jmh8231-Dev/arm-seminar/docs/PPT/ARM/ARM 세미나 8주차.pptx

## ARM Processor

Cortex-M4

세미나 8주차

Robotics 정명훈

## ARM Processor Seminar Roadmap

- 5주

- ADC & DAC

- 4주

- *UART 통신

- 2주

- 3주

- CLCD 출력

- 1주

- ARM 프로세서 개요

*Timer

- PWM

- 6주

- 7주

- USB Mass Storage

- SDIO & FATFS

- 8주

- 9주

- SPI

* 실무에 특화된 응용문제가 존재하는 회차

## Slide 3

세미나 로드맵(상세)

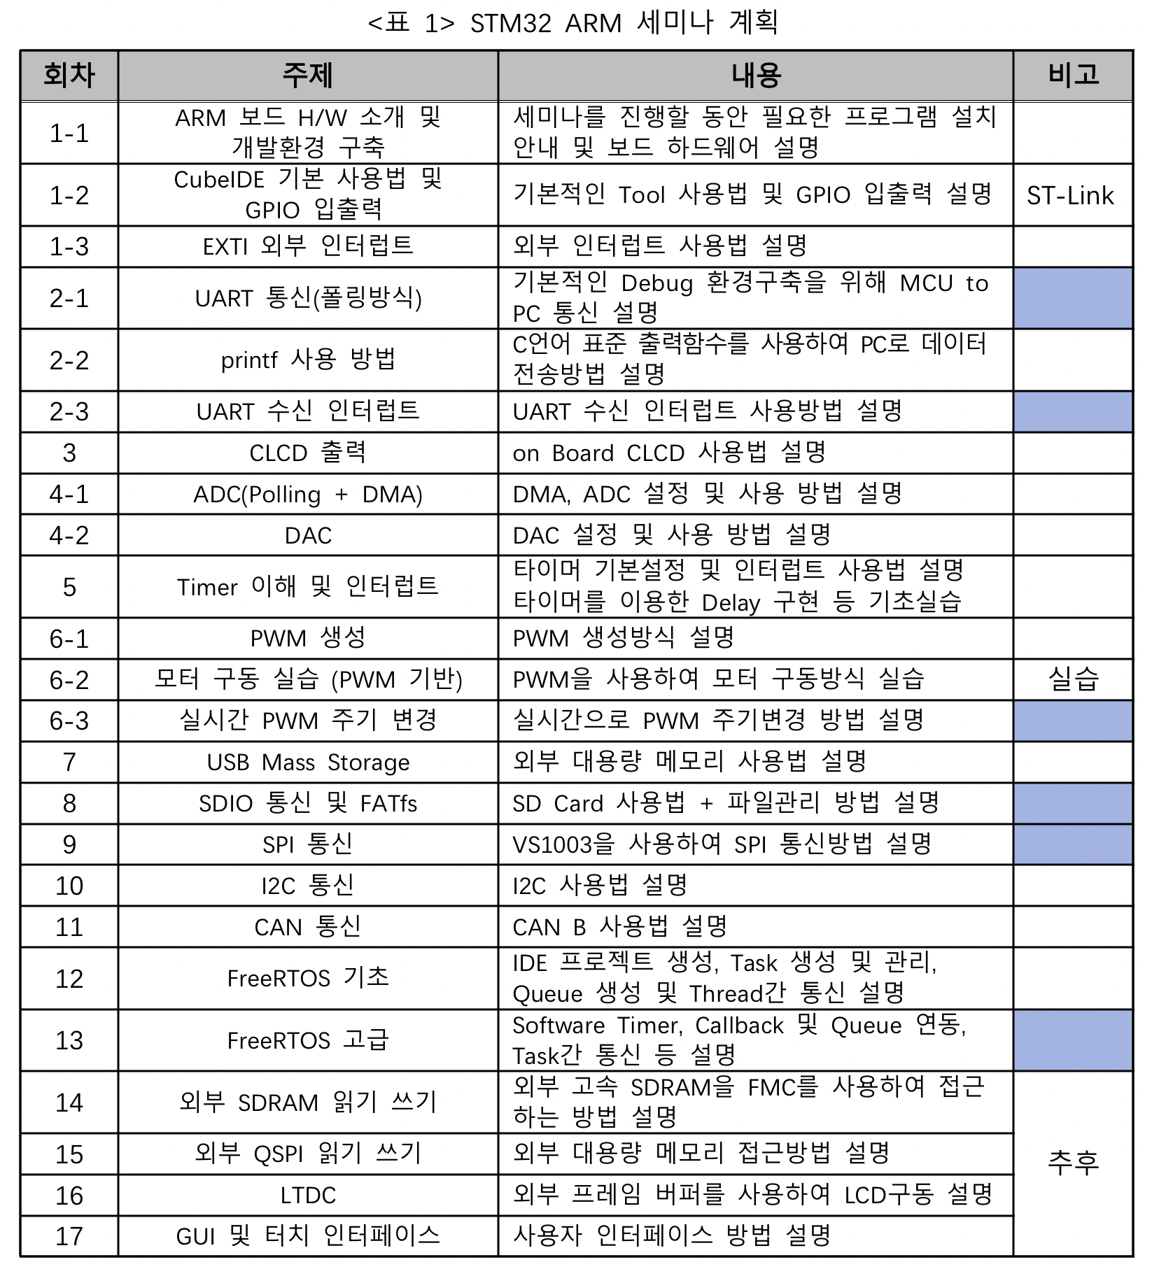
[picture p74: figure]

## 1. SDcard 1-1 MCU 내부 SDIO 하드웨어 설명

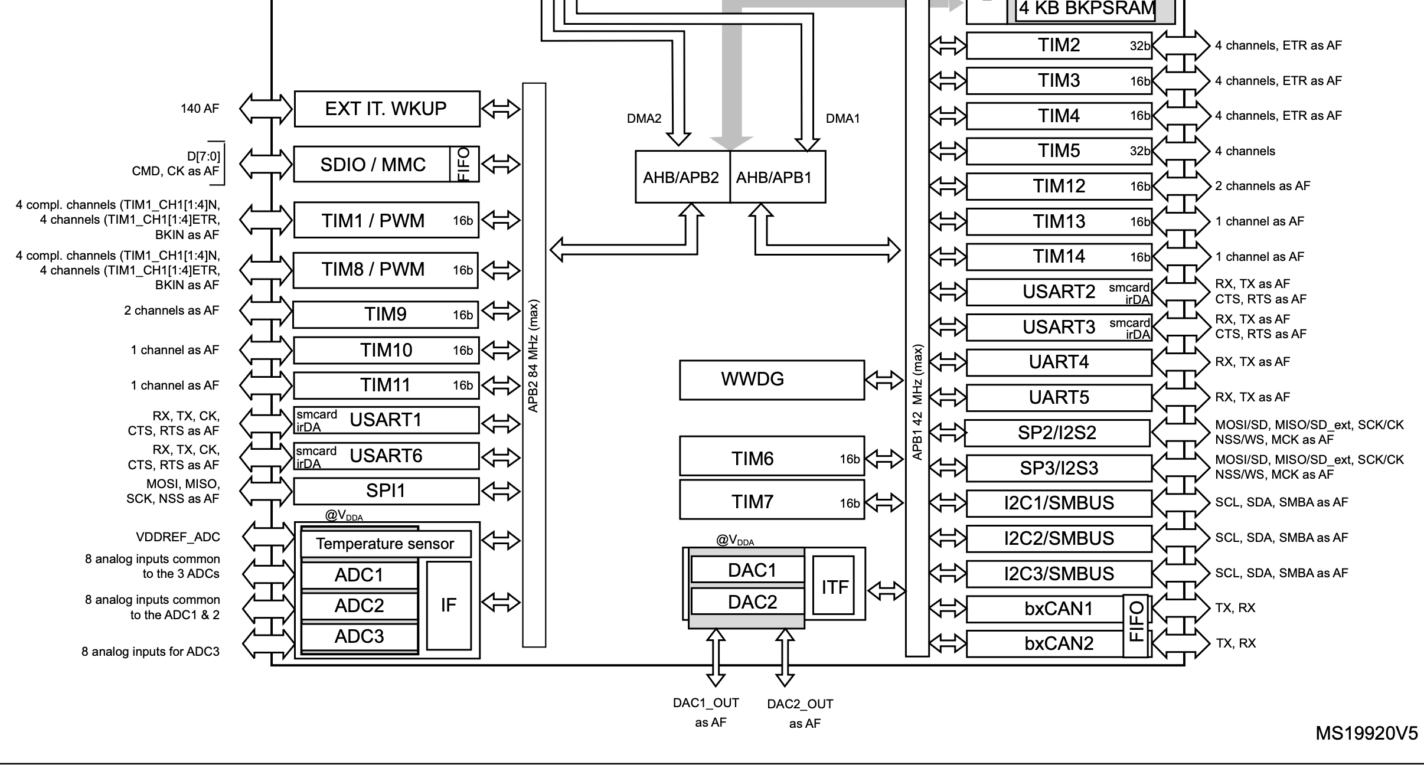
[picture p75: figure]

## 1. SDcard 1-2 PINMAP

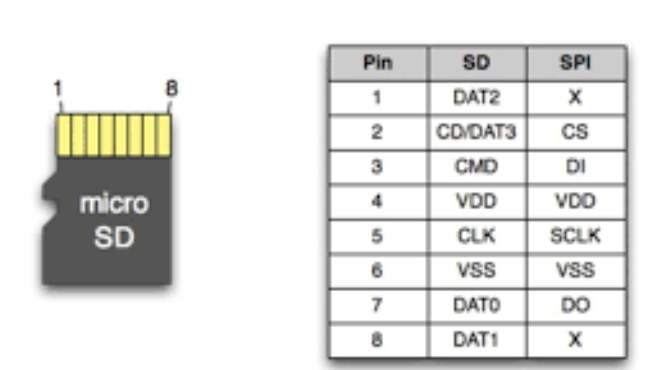
[picture p76: figure]

SDcard는 두가지 통신 방법으로 동작한다.
1. SDIO
2. SPI

## 1. SDcard 1-3 SPI vs SDIO

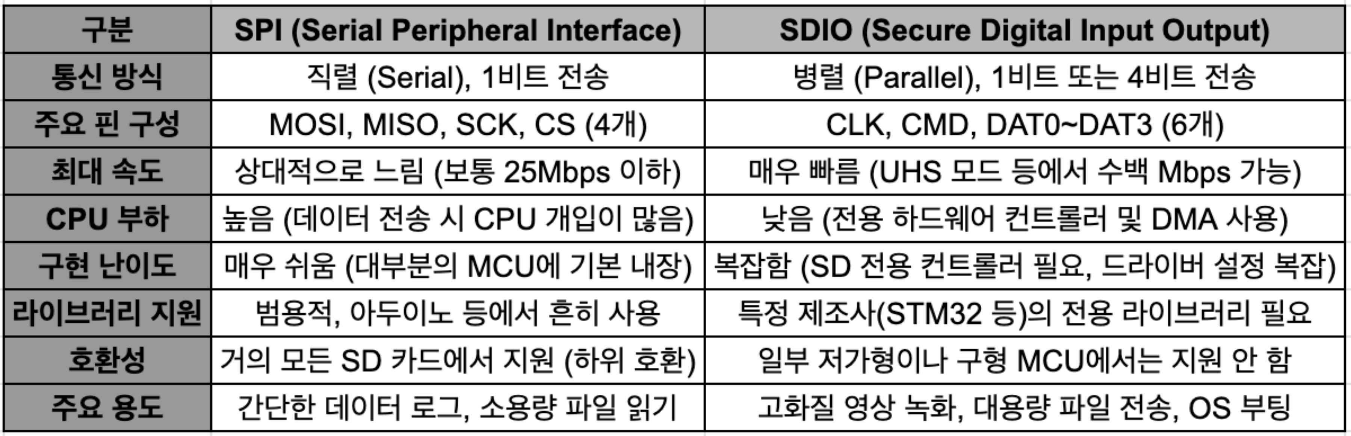
[picture p77: figure]

## 2. SDcard Hardware 2-1 PINMAP

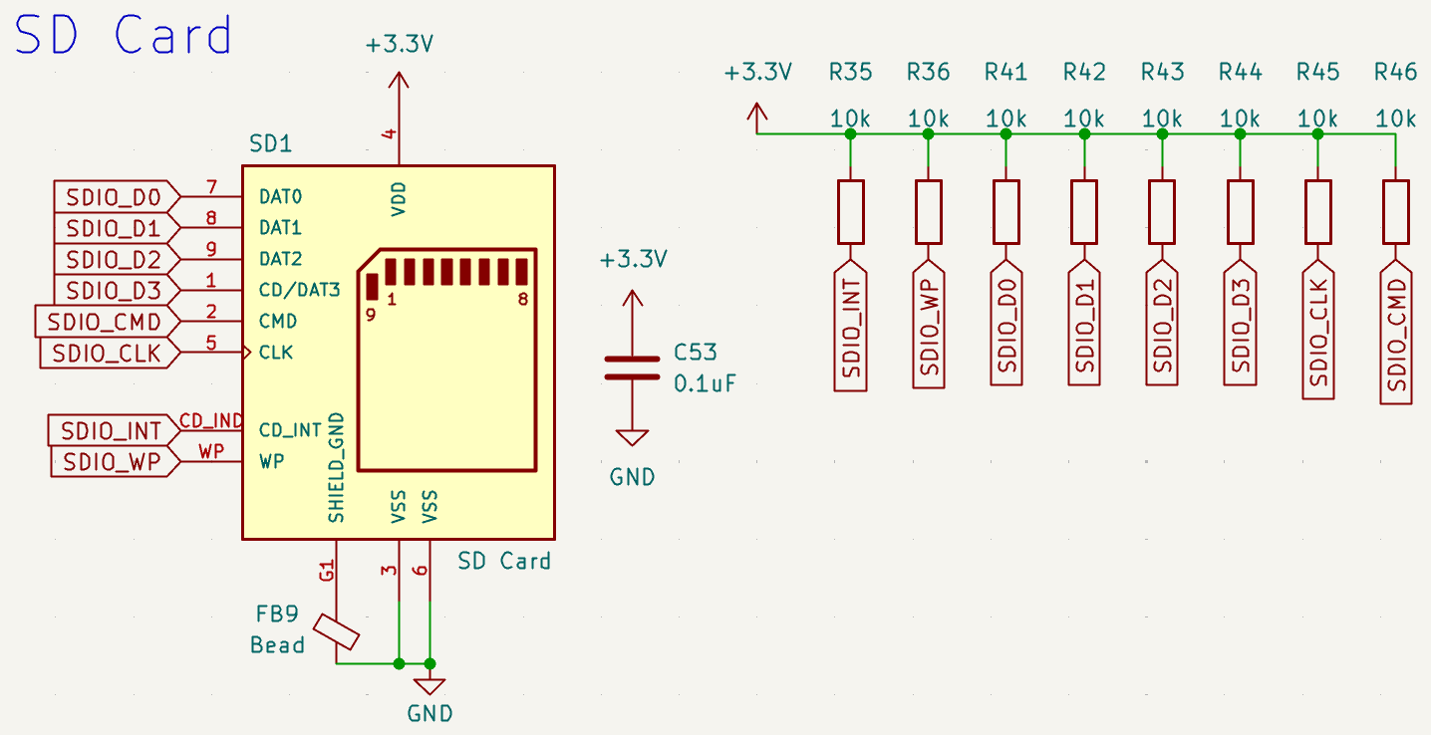
[picture p78: figure]

D0: PC8
D1: PC9
D2: PC10
D3: PC11
CMD: PD2
CLK: PC12
WP: PC6
INT: PC7

*SDIO는 Pull-UP 저항이 필수이다.

## 2. SDcard Hardware 2-2 ArtWork

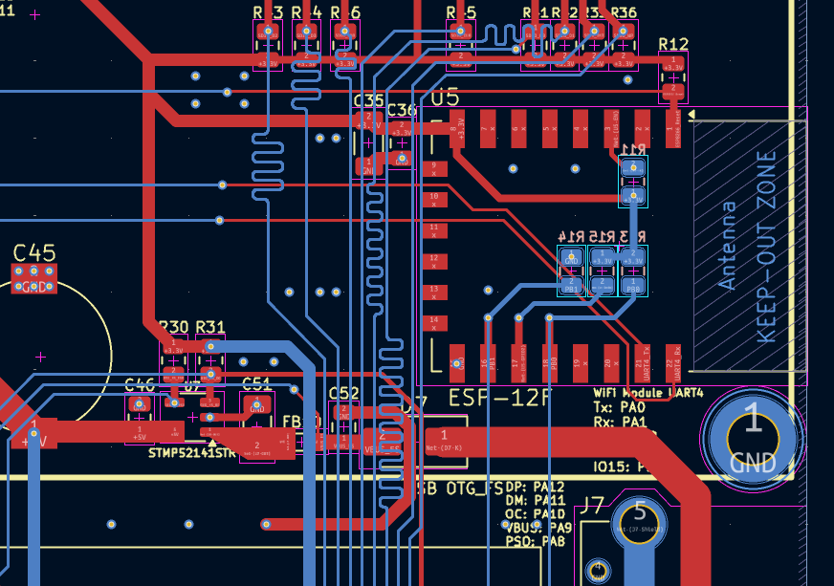
[picture p79: figure]

SDIO는 고속 통신 프로토콜 이므로
임피던스 매칭(단일 종단 50ohm)과 길이 매칭이 요구된다.

## 2. SDcard Hardware 2-3 Layout

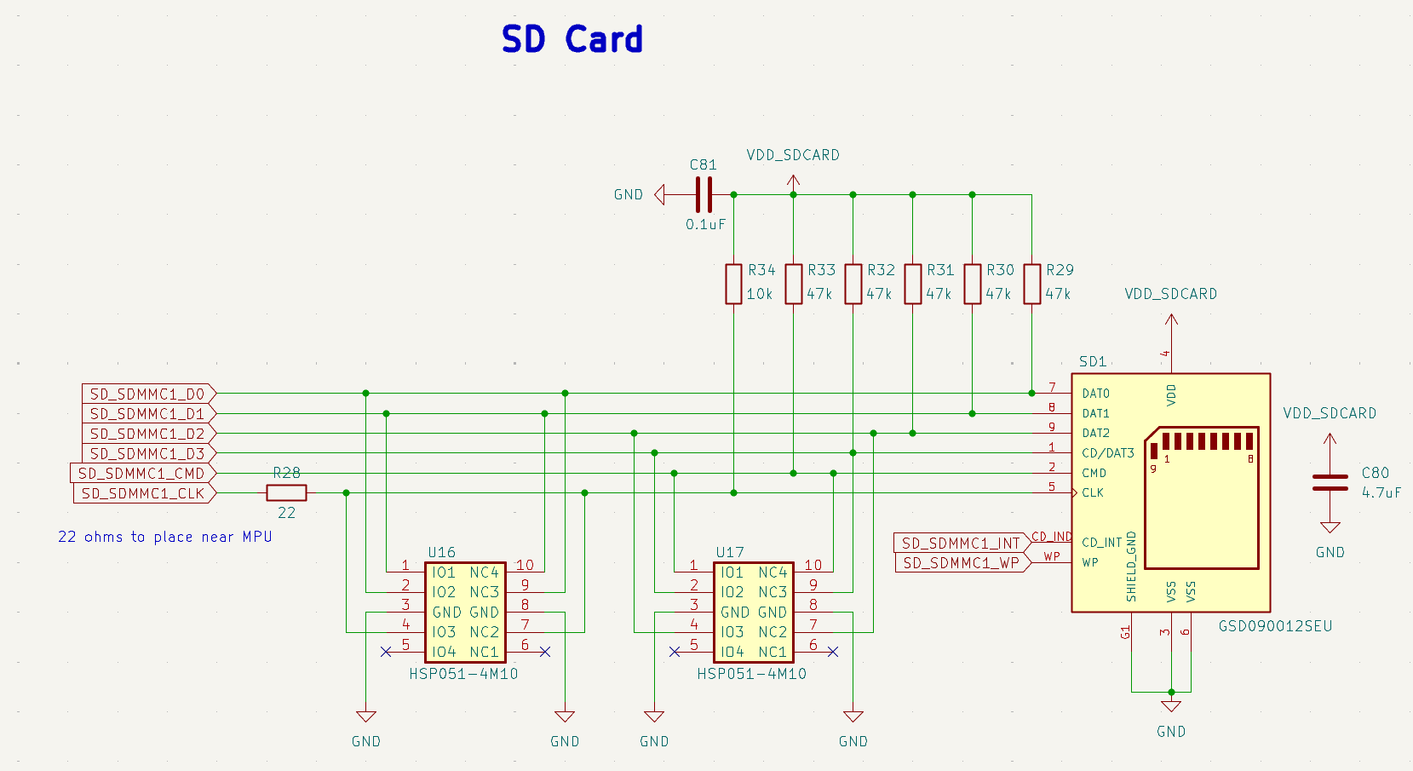
[picture p80: figure]

## 3. STM32CubeMX 설정 방법 3-1 SDIO 활성화

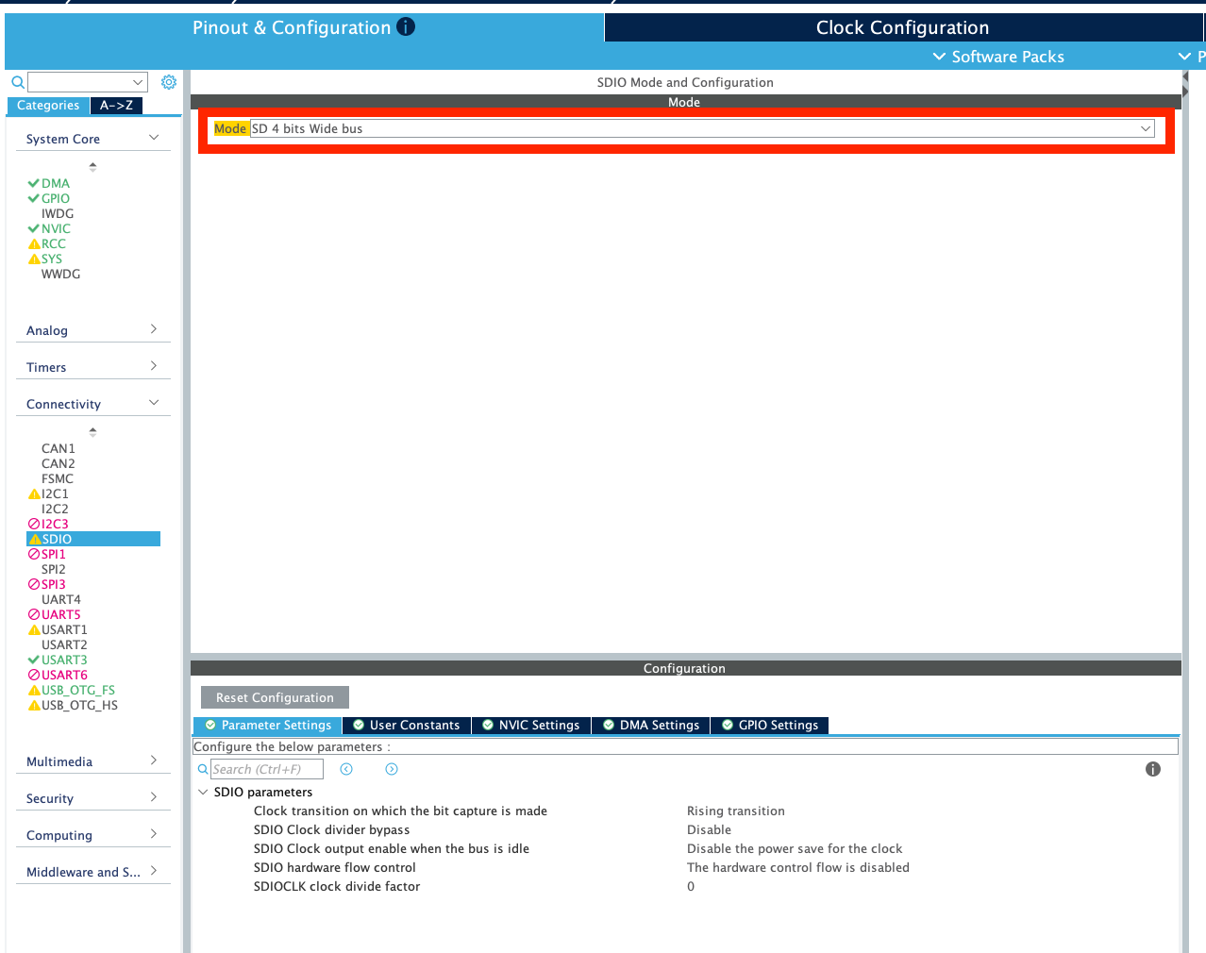
[picture p81: figure]

1. SDIO탭에서 Mode를 SD 4bit Wide bus로 활성화한다.

## 3. STM32CubeMX 설정 방법 3-2 SDIO DMA 및 인터럽트 활성화

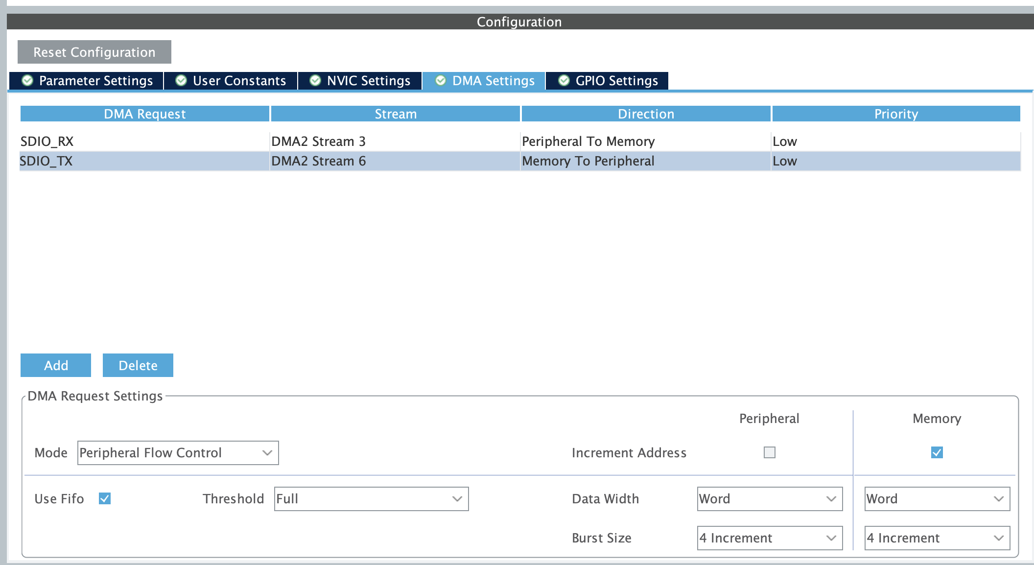
[picture p82: figure]

2. DMA Settings 탭에서 Rx, Tx DMA를 활성화 한다.
3. NVIC Settings 탭에서 글로벌 인터럽트를 활성화

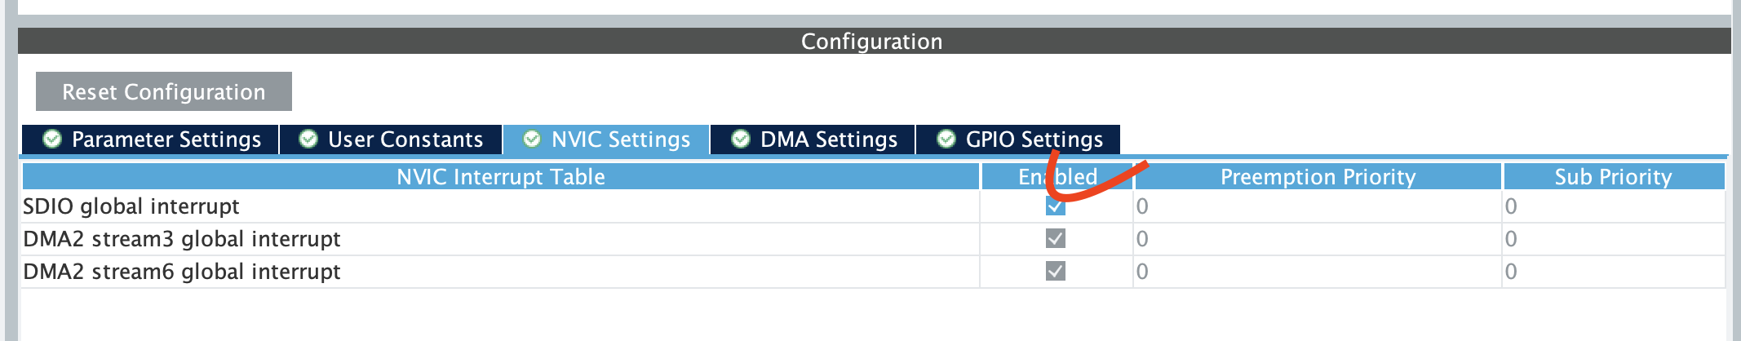
[picture p83: figure]

*만약 인터럽트를 활성화 하지 않는다면 DMA 통신에 문제가 생길 수 있다.

## 3. STM32CubeMX 설정 방법 3-3 FATFS 설정

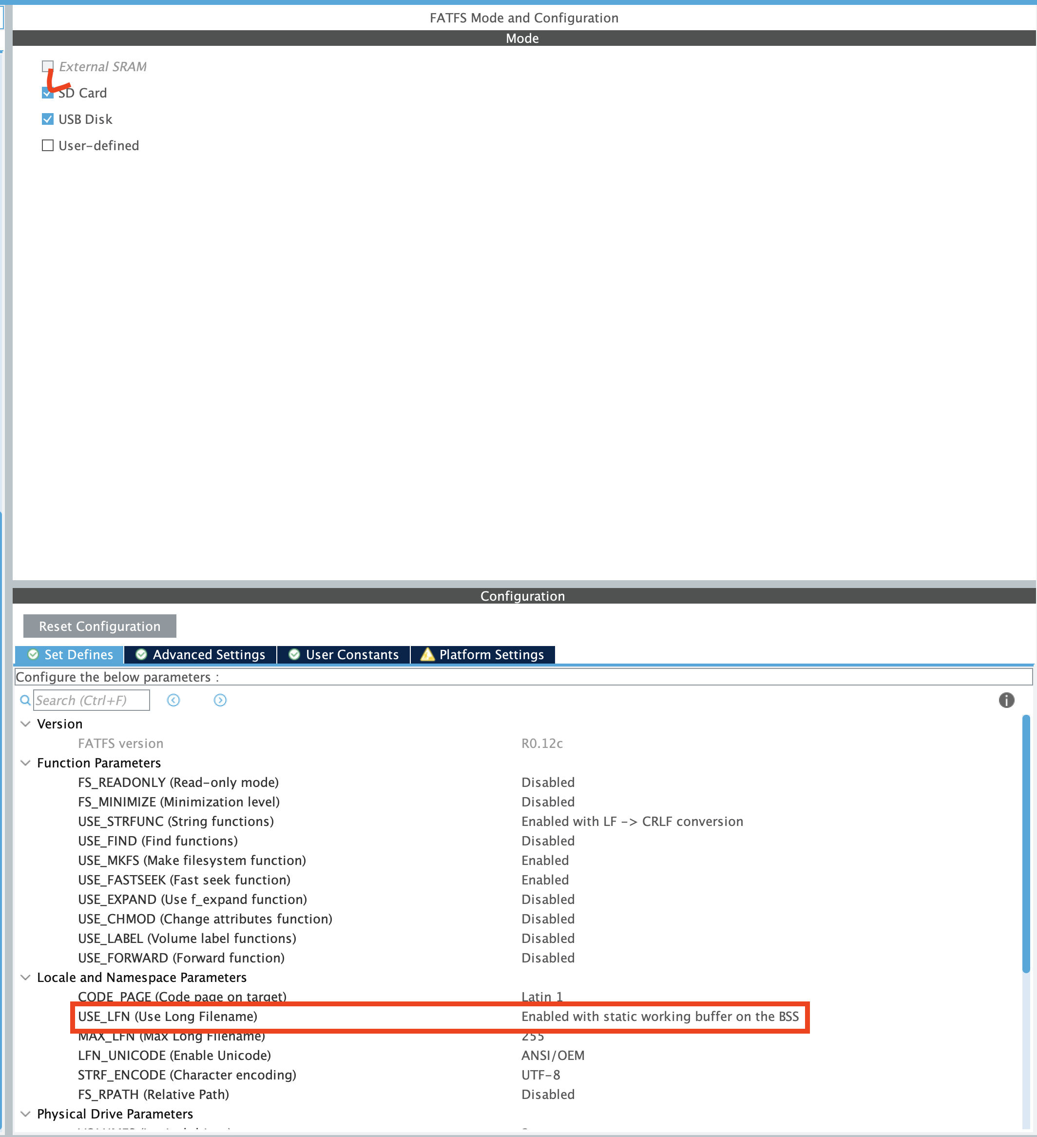
[picture p84: figure]

4. FATFS에서 SD Card를 활성화 해준다.

*이때 USE_LFN도 활성화 되어 있어야 이름이 긴 파일에 접근할 수 있다.

## 3. STM32CubeMX 설정 방법 3-4 FATFS 설정(DMA)

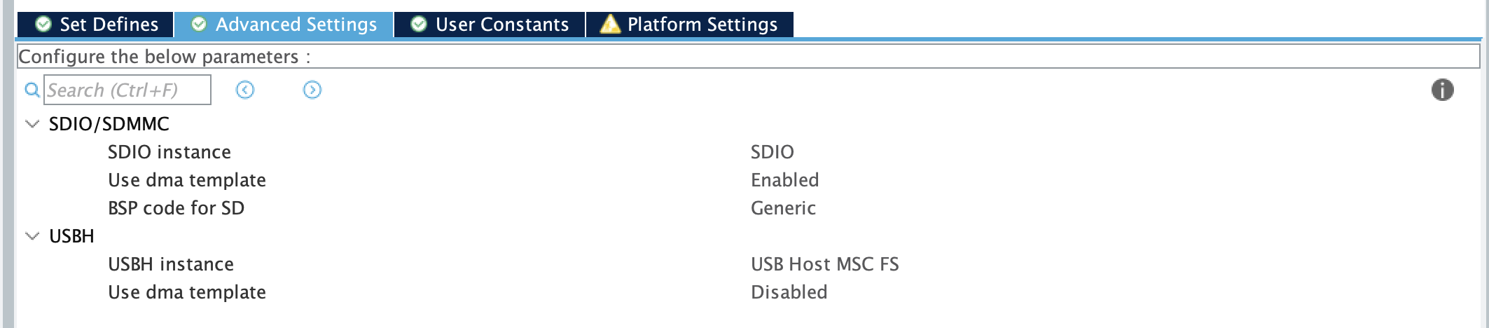
[picture p85: figure]
스크린샷, 텍스트, 소프트웨어이(가) 표시된 사진 AI 생성 콘텐츠는 정확하지 않을 수 있습니다.

5. DMA를 사용하여 통신하므로
Use dma template을 활성화 해야 한다.

## 4. STM32CubeIDE 4-1 f_mount

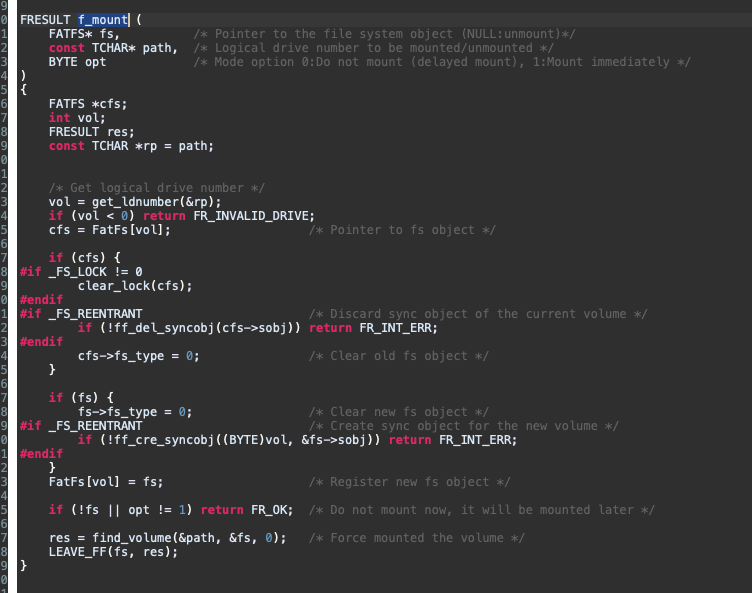
[picture p86: figure]

f_mount 함수는 매개변수가 3개이다.
이때 만약 opt = 1이라면 즉시 마운트를 시도하기 때문에
시점에 따라 opt 조절이 필요하다.

## Slide 15

회로판

실습
