jmh8231-Dev/arm-seminar/docs/Ref/PINMAP.png

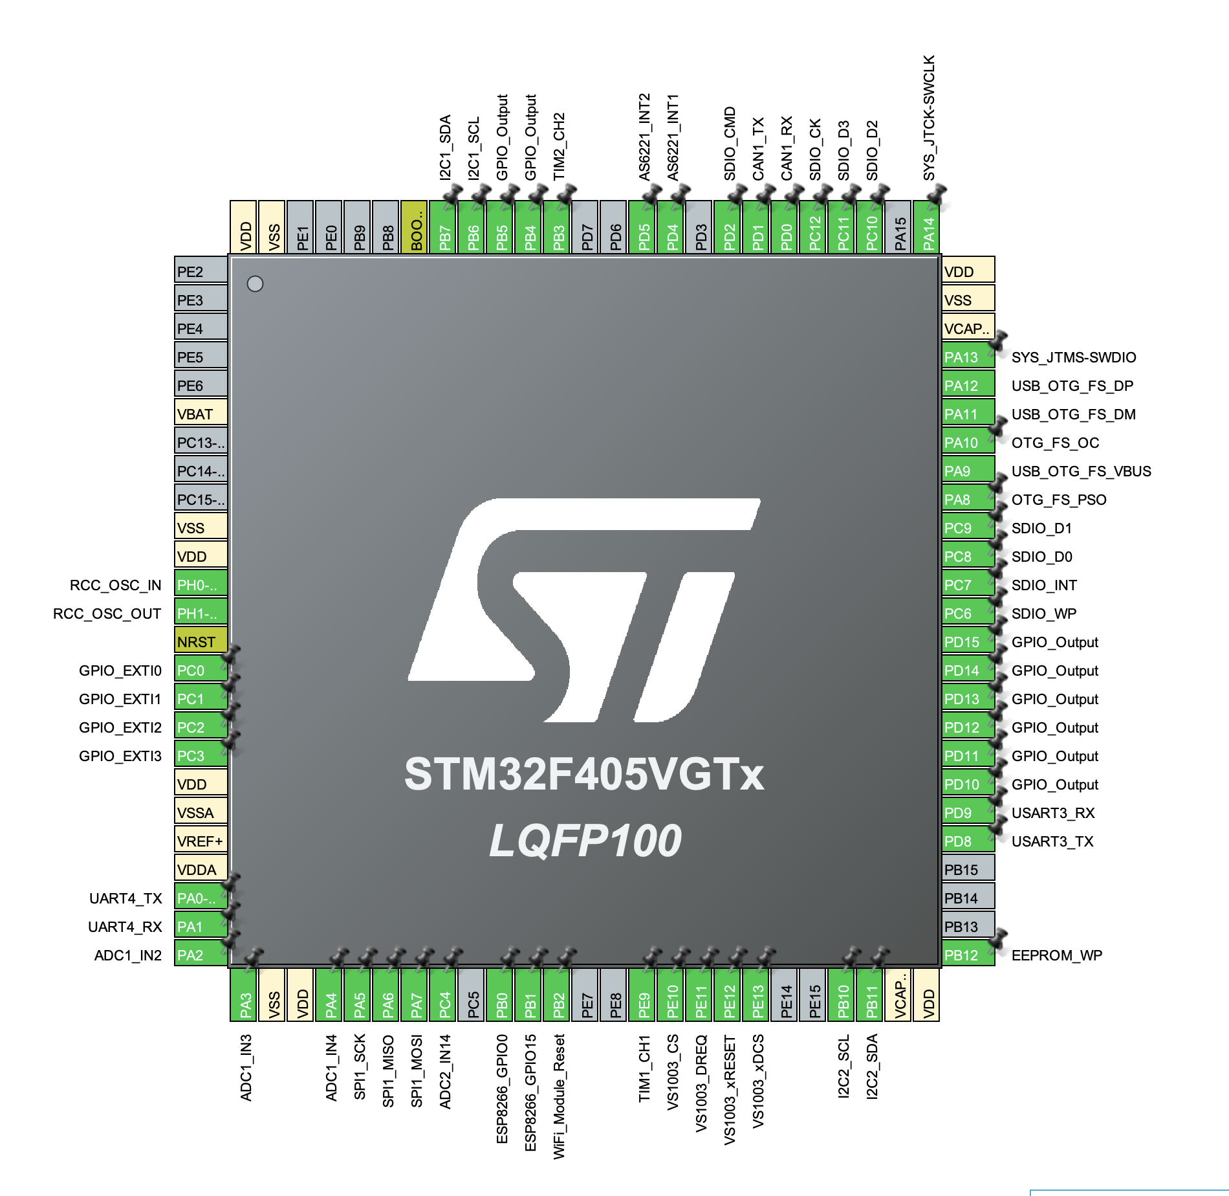
docs/Ref/PINMAP.png
