jmh8231-Dev/arm-seminar/docs/Ref/ESP32 업로드 회로(USB 커넥터 별도).pdf

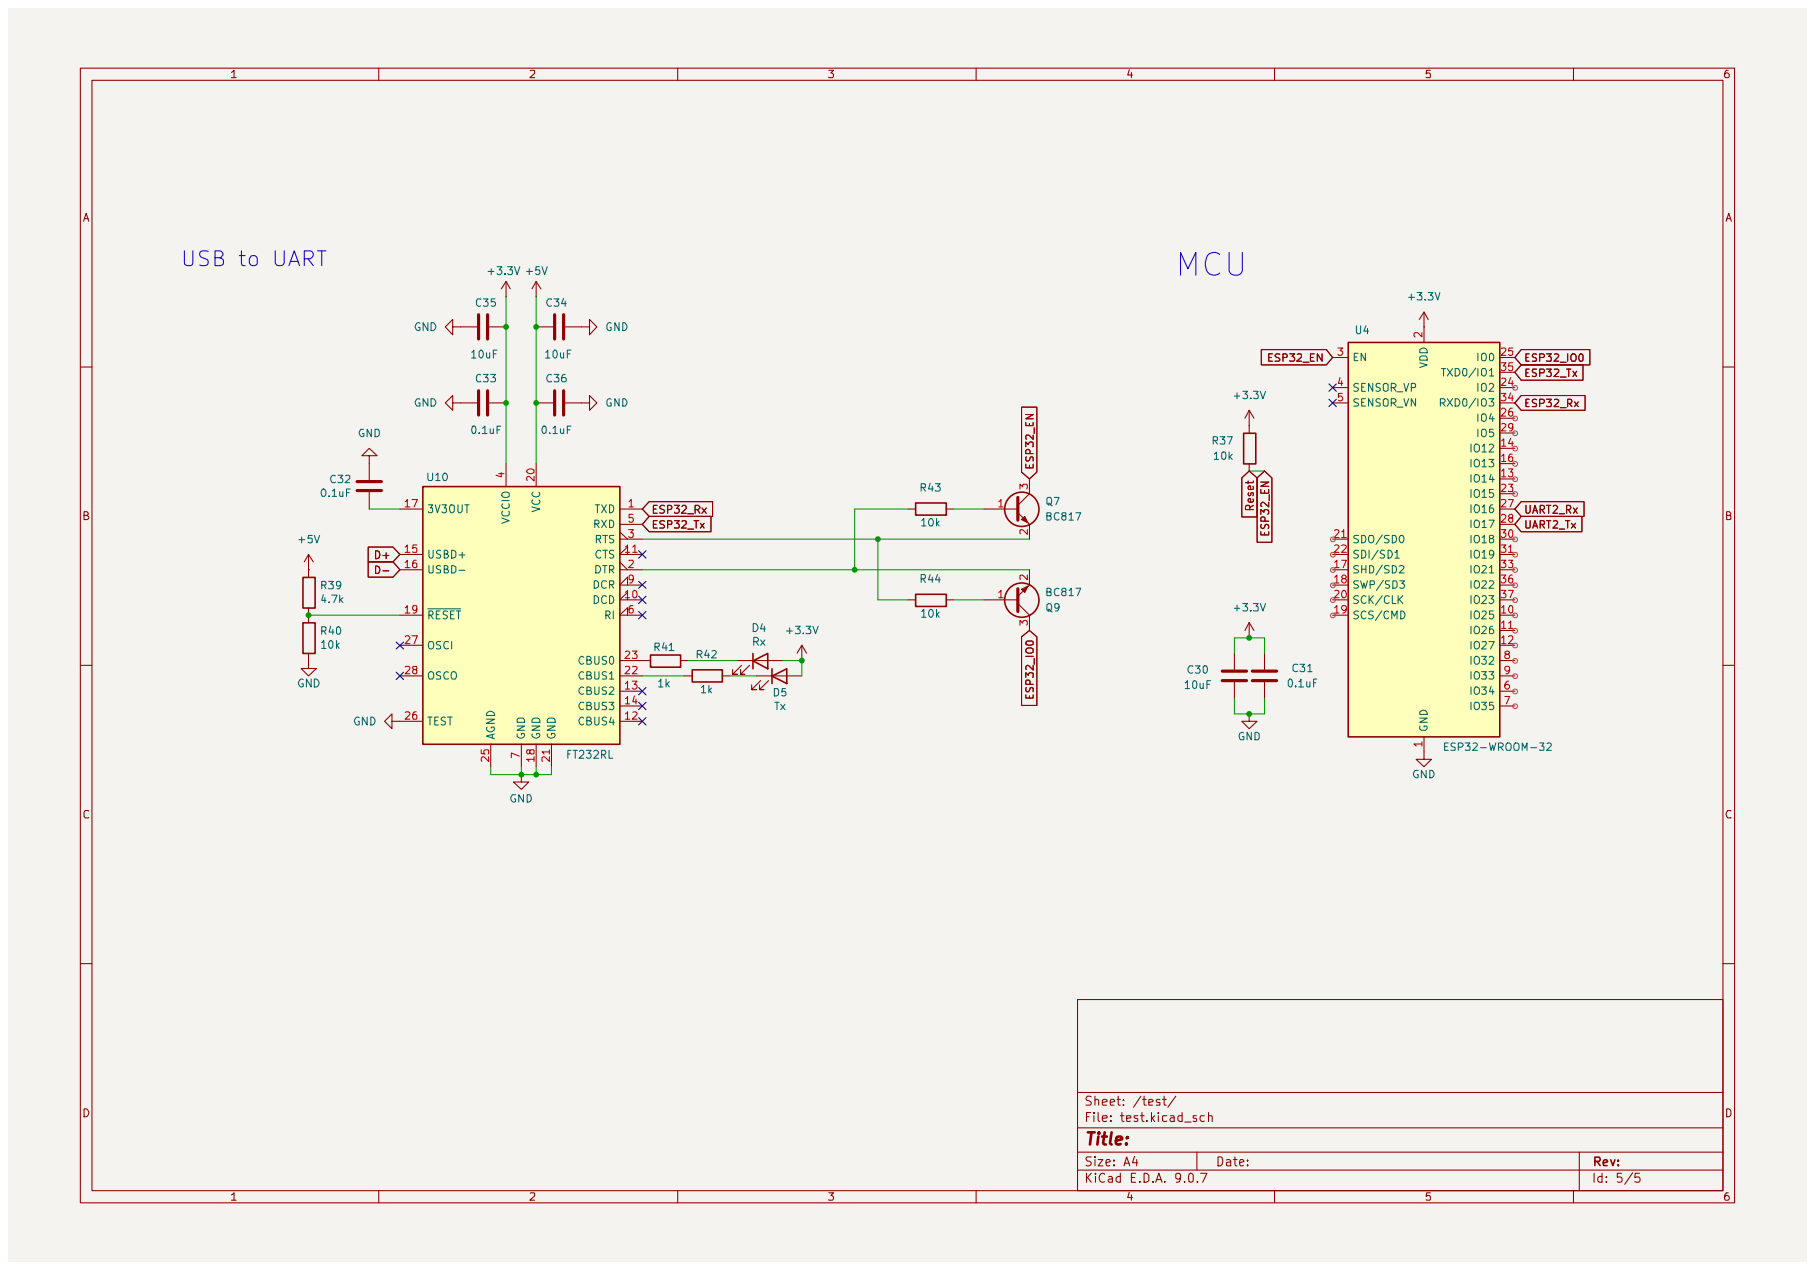
[picture p253: page 1]
