jmh8231-Dev/arm-seminar/docs/Ref/ARM Training Kit v2.0 sch.pdf

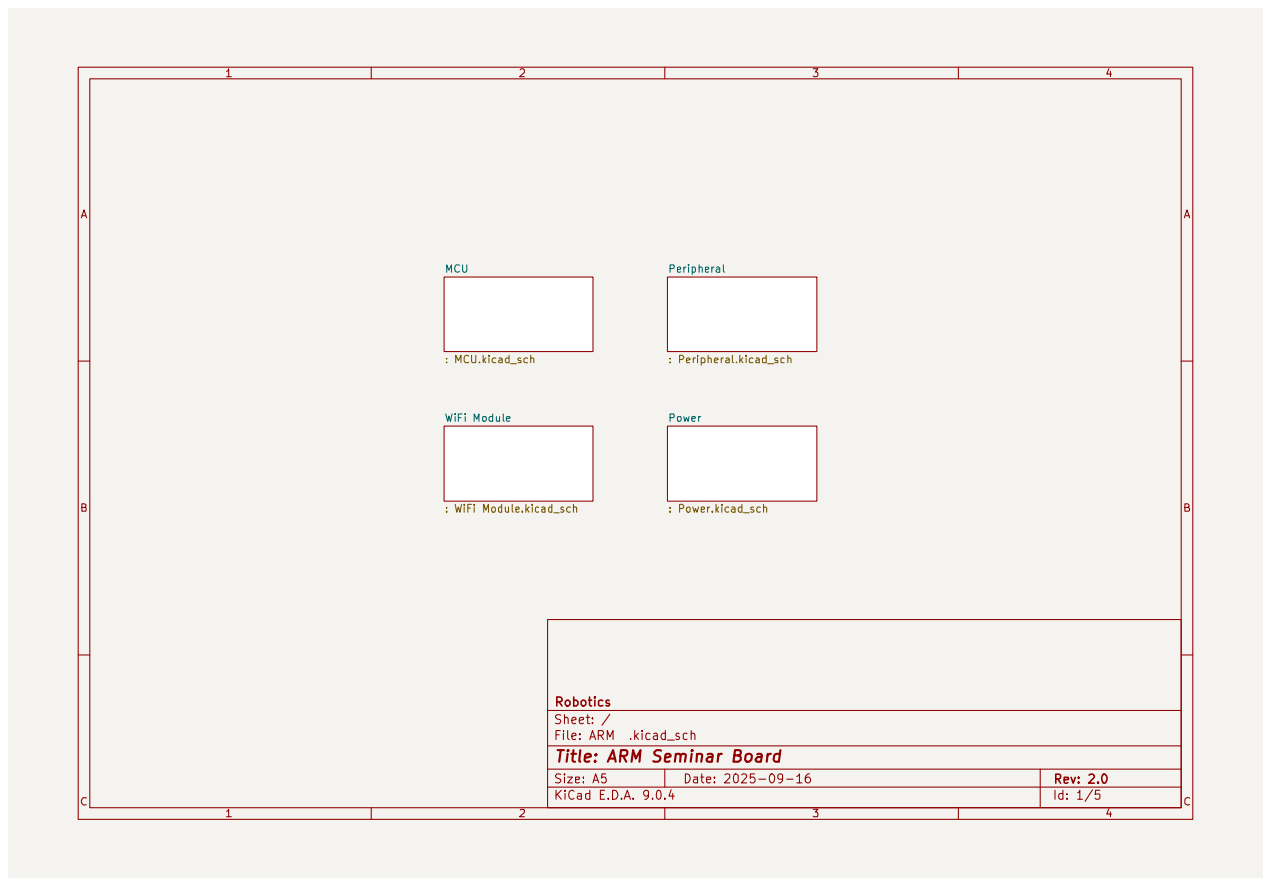
[picture p254: page 1]

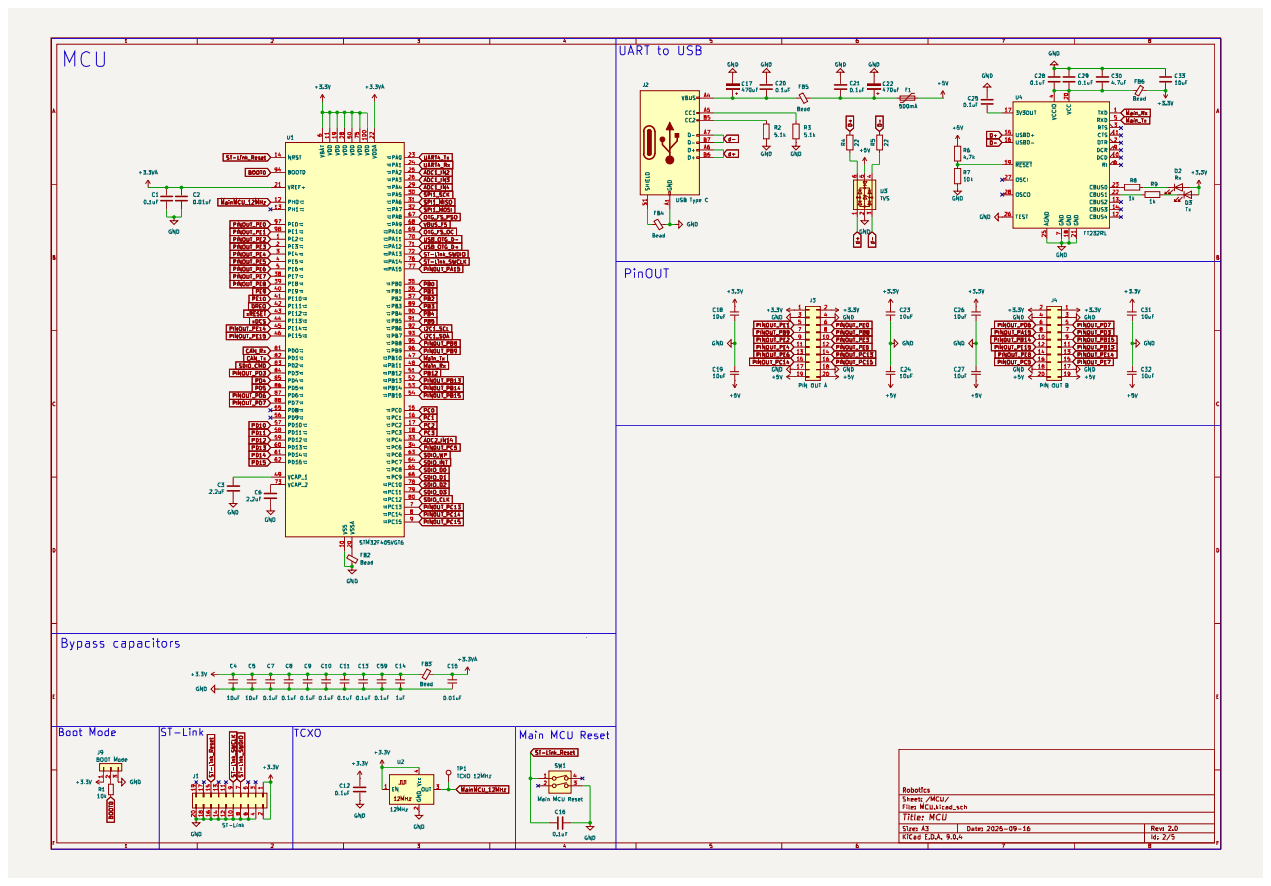
[picture p255: page 2]

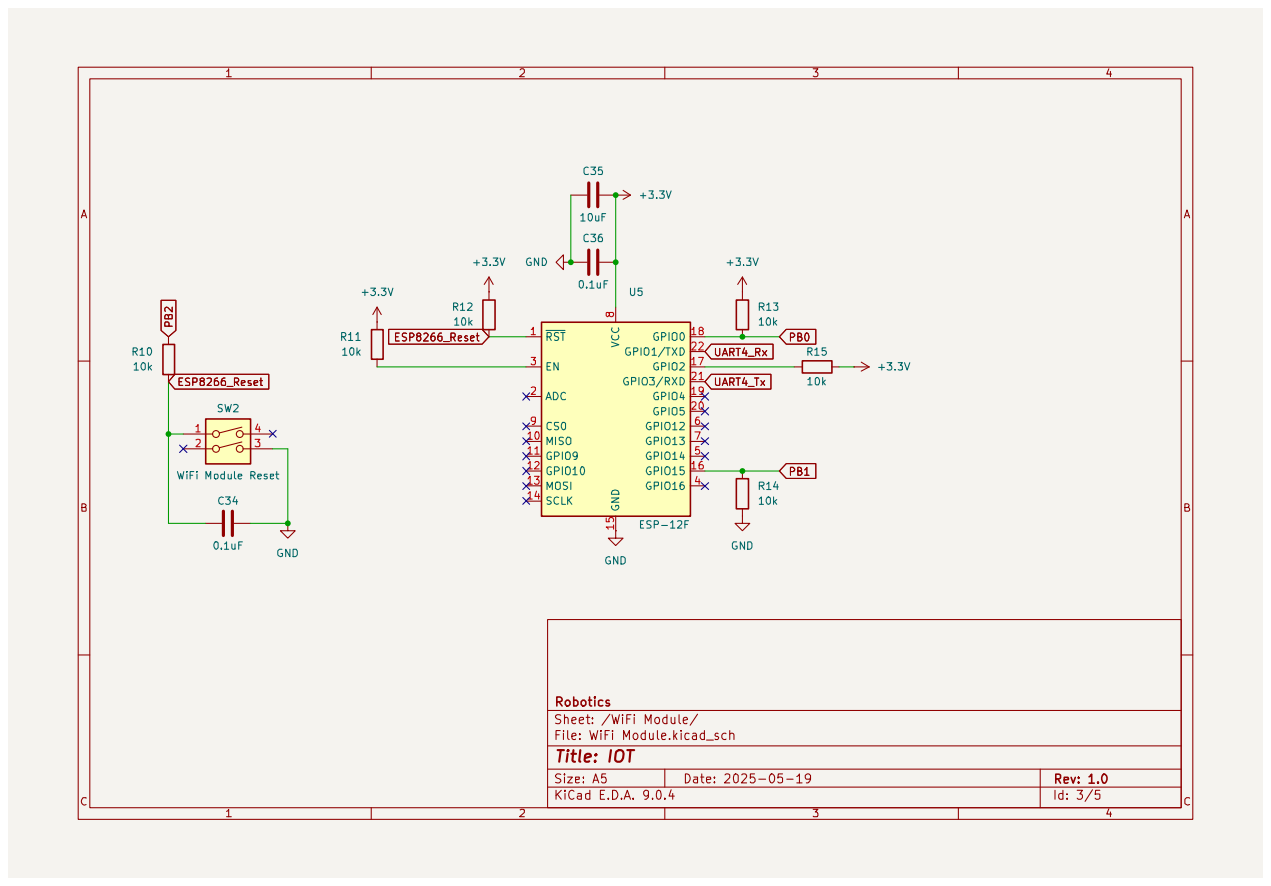
[picture p256: page 3]

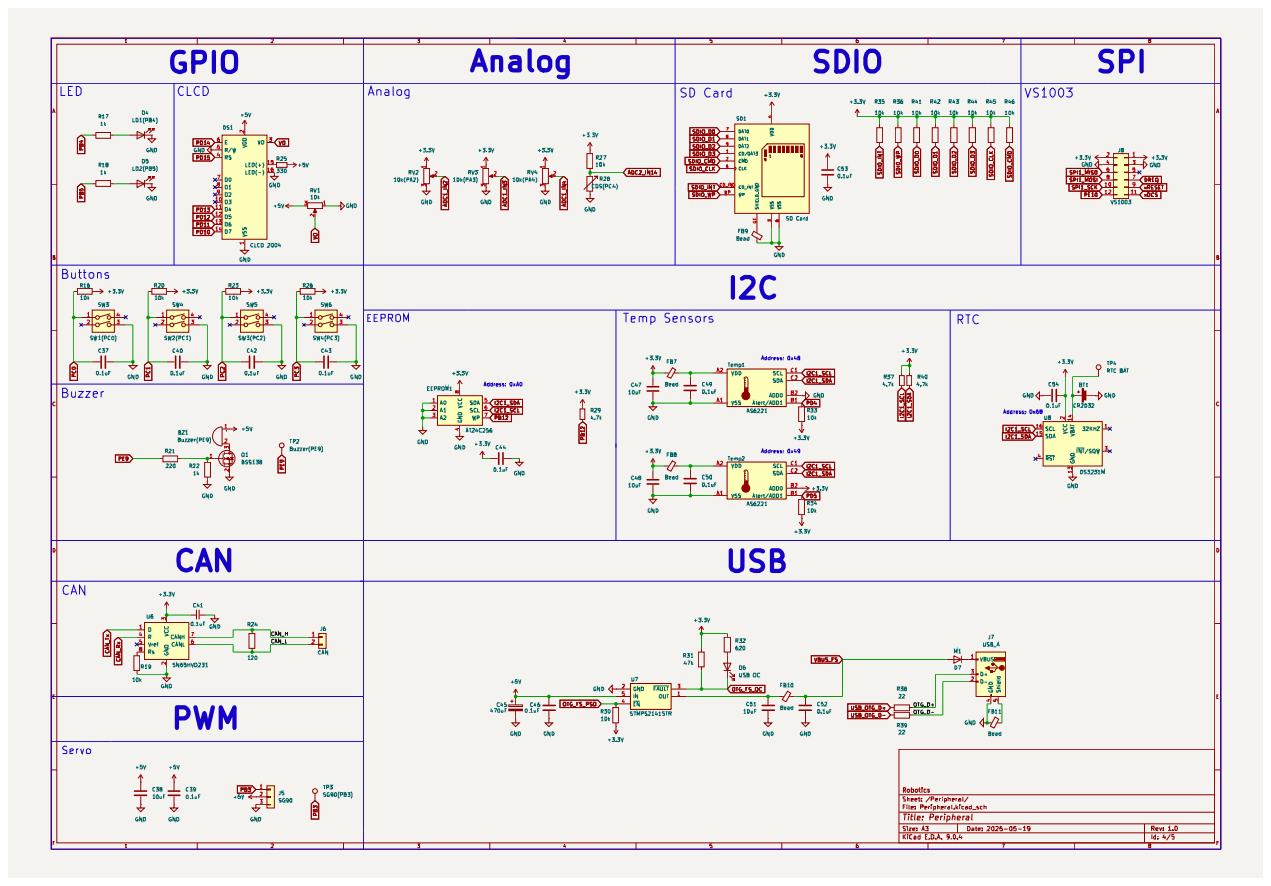
[picture p257: page 4]

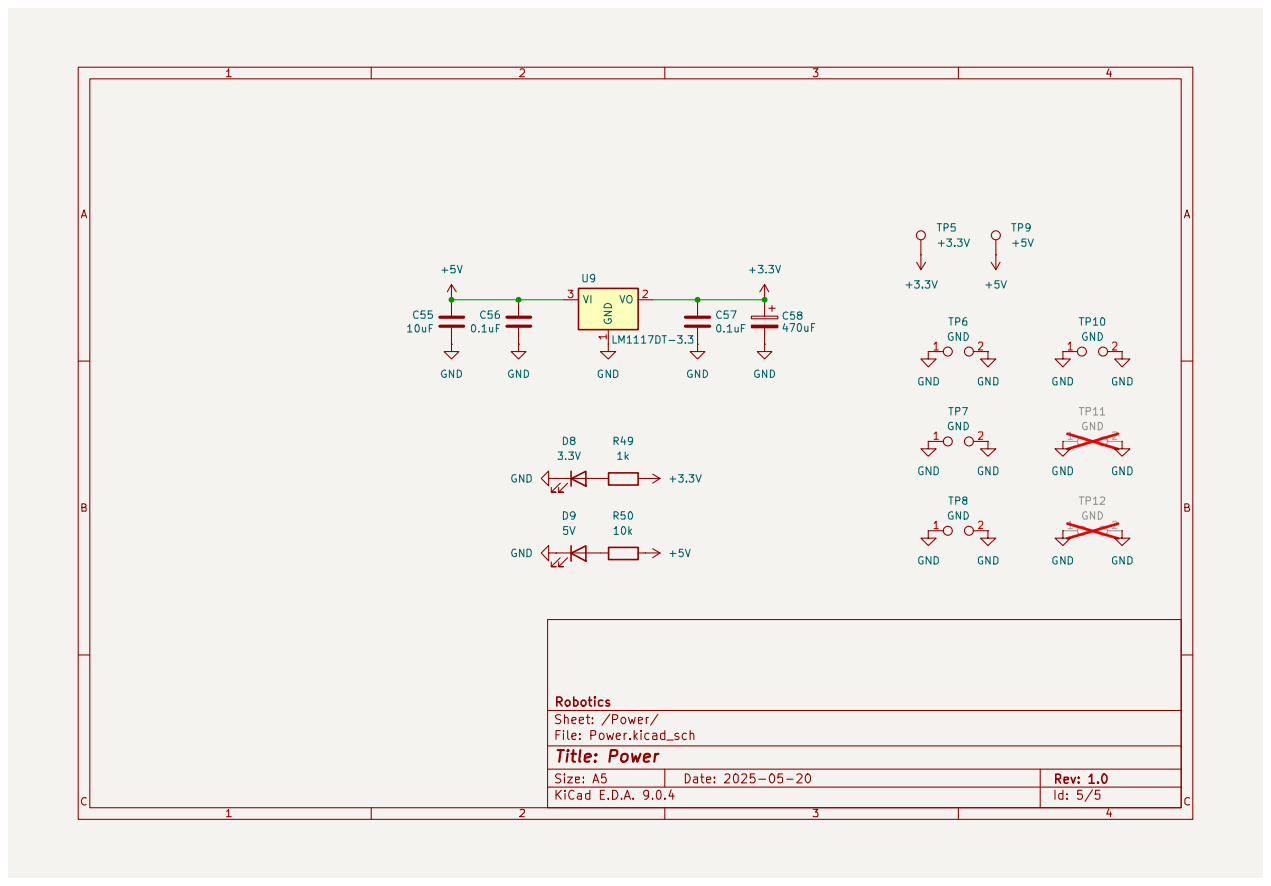
[picture p258: page 5]
