jmh8231-Dev/arm-seminar/HW/Ver 2.0/ARM 세미나 보드.kicad_pcb

## KiCad design HW/Ver 2.0/ARM 세미나 보드.kicad_pcb (2025-09-17)

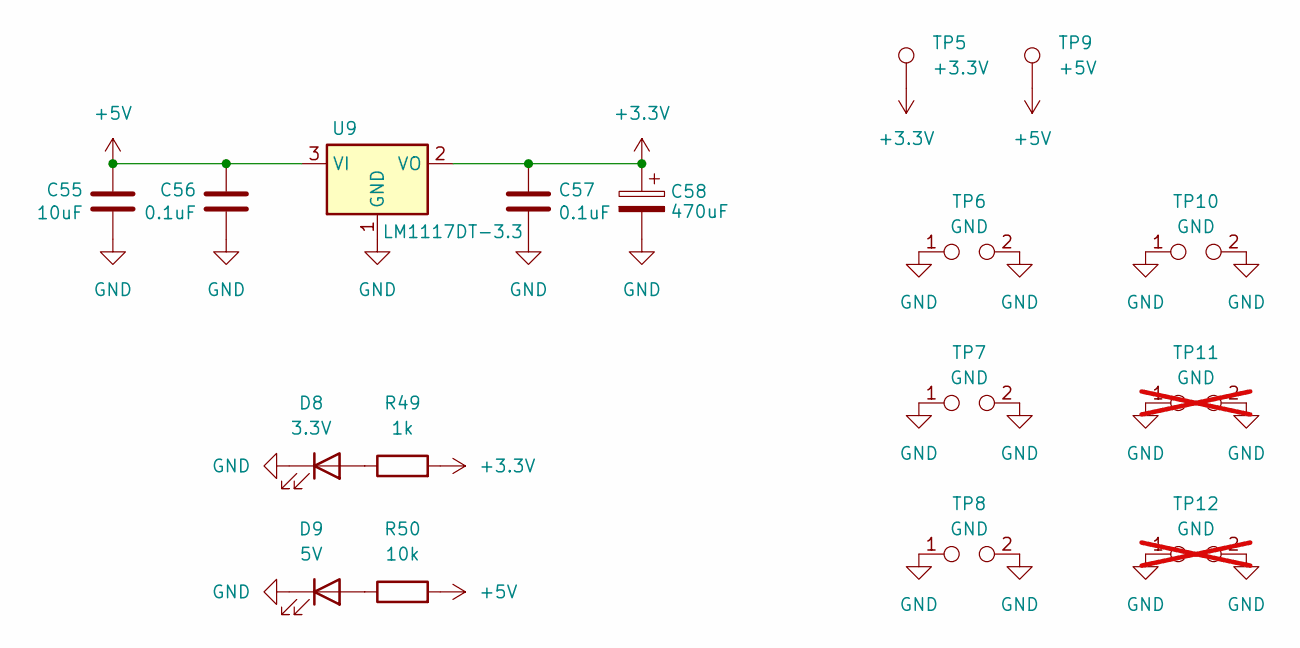
[picture p259: schematic Power.kicad_sch]

Parts:
C55: 10uF; C_1206_3216Metric
C56, C57: 0.1uF; C_0805_2012Metric
C58: 470uF; MVG25WV470M
D8: 3.3V; LED_0805_2012Metric
D9: 5V; LED_0805_2012Metric
R49: 1k; R_0805_2012Metric
R50: 10k; R_0805_2012Metric
TP5: +3.3V; TestPoint_Pad_D1.5mm
TP6, TP7, TP8, TP10: GND; TestPoint_2Pads_Pitch5.08mm_Drill1.3mm
TP9: +5V; TestPoint_Pad_D1.5mm
TP11, TP12: GND; TestPoint_2Pads_Pitch5.08mm_Drill1.3mm; not fitted
U9: LM1117DT-3.3; TO-252-3_TabPin2

Connections:
+3.3V: C57.2, C58.1, R49.2, TP5.1, U9.2 (VO); also elsewhere on the board
+5V: C55.2, C56.2, R50.2, TP9.1, U9.3 (VI); also elsewhere on the board
GND: C55.1, C56.1, C57.1, C58.2, D8.1 (K), D9.1 (K), TP6.1, TP6.2, TP7.1, TP7.2, TP8.1, TP8.2, TP10.1, TP10.2, TP11.1, TP11.2, TP12.1, TP12.2, U9.1 (GND); also elsewhere on the board
unnamed: D8.2 (A), R49.1
unnamed: D9.2 (A), R50.1

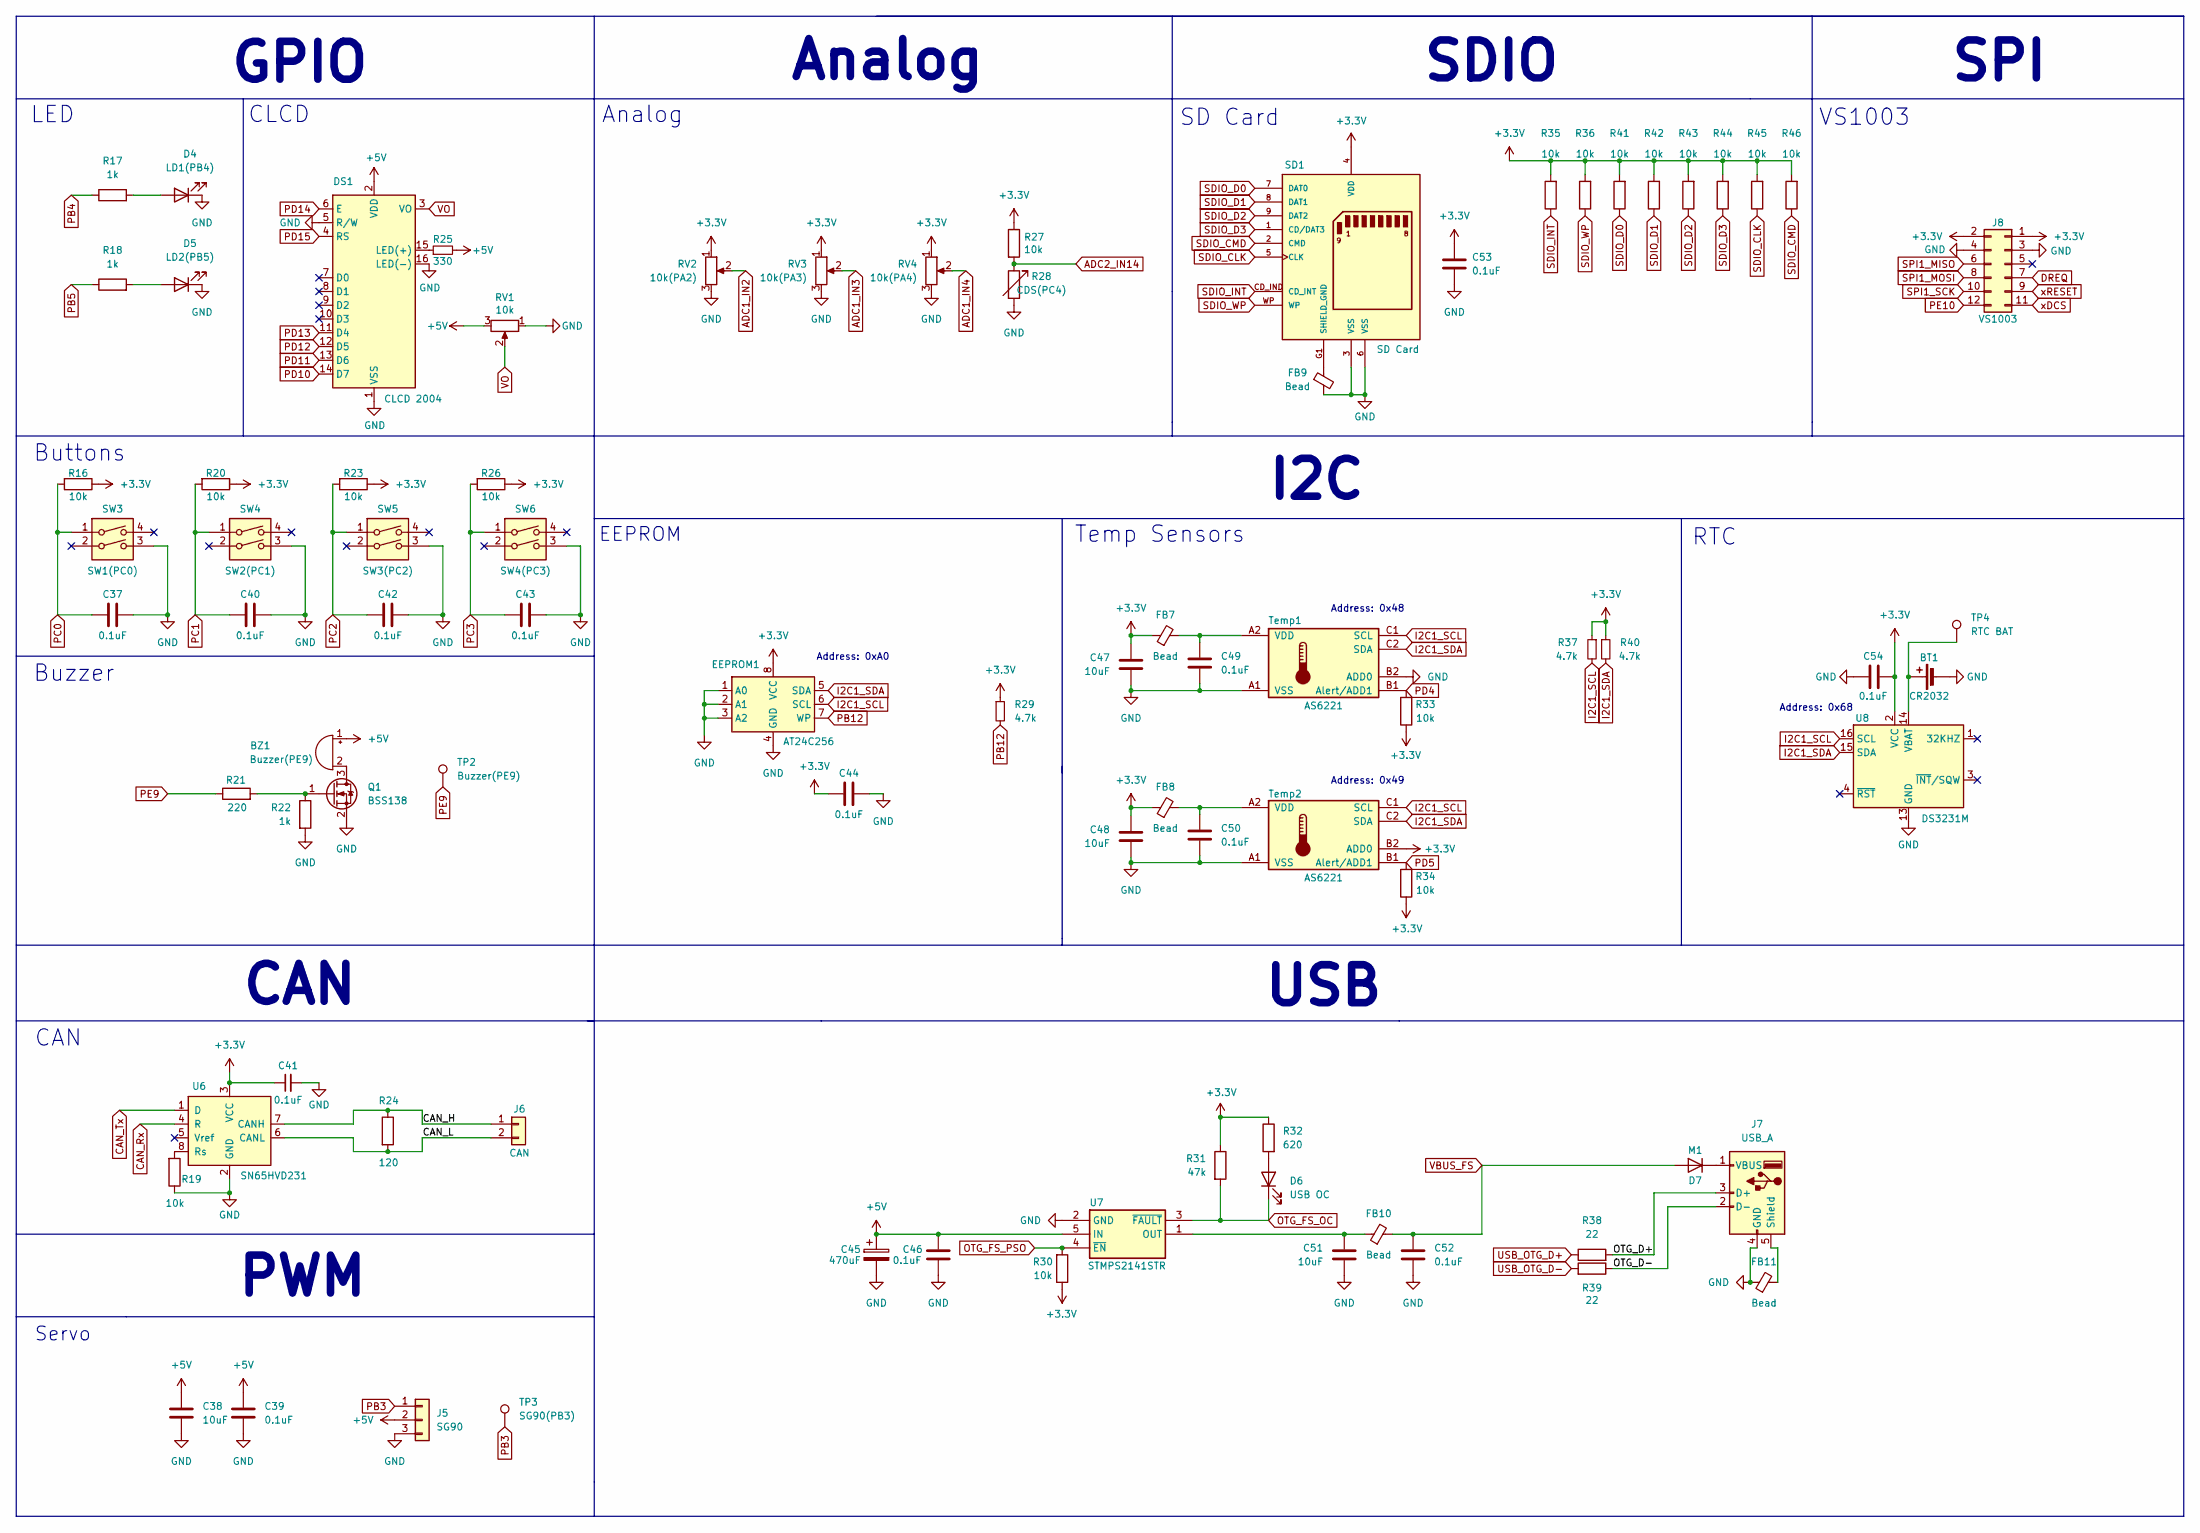
[picture p260: schematic Peripheral.kicad_sch]

Parts:
BT1: CR2032; BAT-HLD-001
BZ1: Buzzer(PE9); Buzzer_12x9.5RM7.6
C37, C39, C40, C41, C42, C43, C44, C46, C49, C50, C52, C53, C54: 0.1uF; C_0805_2012Metric
C38, C47, C48, C51: 10uF; C_1206_3216Metric
C45: 470uF; MVG25WV470M
D4: LD1(PB4); LED_0805_2012Metric
D5: LD2(PB5); LED_0805_2012Metric
D6: USB OC; LED_0805_2012Metric
D7: M1; D_SMA
DS1: CLCD 2004; LCD-20x4
EEPROM1: AT24C256; SOIC-8_3.9x4.9mm_P1.27mm
FB7, FB8, FB9, FB10, FB11: Bead; L_0805_2012Metric
J5: SG90; PinHeader_1x03_P2.54mm_Vertical
J6: CAN; PinHeader_1x02_P2.54mm_Vertical
J7: USB_A; USB_A_Connfly_DS1095
J8: VS1003; PinSocket_2x06_P2.54mm_Vertical
Q1: BSS138; SOT-23
R16, R19, R20, R23, R26, R27, R30, R33, R34, R35, R36, R41, R42, R43, R44, R45, R46: 10k; R_0805_2012Metric
R17, R18, R22: 1k; R_0805_2012Metric
R21: 220; R_0805_2012Metric
R24: 120; R_0805_2012Metric
R25: 330; R_0805_2012Metric
R28: CDS(PC4); R_LDR_5.0x4.1mm_P3mm_Vertical
R29, R37, R40: 4.7k; R_0805_2012Metric
R31: 47k; R_0805_2012Metric
R32: 620; R_0805_2012Metric
R38, R39: 22; R_0805_2012Metric
RV1: 10k; 3362P-103LF
RV2: 10k(PA2); RV09H20SQ-B10K
RV3: 10k(PA3); RV09H20SQ-B10K
RV4: 10k(PA4); RV09H20SQ-B10K
SD1: SD Card; AMPHENOL_GSD090012SEU; PARTREV E
SW3: SW1(PC0); SW_SMD_IT-1107
SW4: SW2(PC1); SW_SMD_IT-1107
SW5: SW3(PC2); SW_SMD_IT-1107
SW6: SW4(PC3); SW_SMD_IT-1107
TP2: Buzzer(PE9); TestPoint_Pad_D1.5mm
TP3: SG90(PB3); TestPoint_Pad_D1.5mm
TP4: RTC BAT; TestPoint_Pad_D1.5mm
Temp1, Temp2: AS6221; WLCSP-6_1.4x1.0mm_P0.4mm
U6: SN65HVD231; SOIC-8_3.9x4.9mm_P1.27mm
U7: STMPS2141STR; SOT-23-5
U8: DS3231M; SOIC-16W_7.5x10.3mm_P1.27mm

Connections:
+3.3V: C41.1, C44.1, C47.2, C48.2, C53.1, C54.2, EEPROM1.8 (VCC), FB7.1, FB8.1, J8.1, J8.2, R16.1, R20.1, R23.1, R26.1, R27.1, R29.1, R30.1, R31.1, R32.1, R33.1, R34.1, R35.2, R36.2, R37.1, R40.1, R41.2, R42.2, R43.2, R44.2, R45.2, R46.2, RV2.1, RV3.1, RV4.1, SD1.4 (VDD), Temp2.B2 (ADD0), U6.3 (VCC), U8.2 (VCC); also elsewhere on the board
+5V: BZ1.1 (+), C38.1, C39.1, C45.1, C46.1, DS1.2 (VDD), J5.2, R25.2, RV1.3, U7.5 (IN); also elsewhere on the board
/Peripheral/CAN_H: J6.1, R24.1, U6.7 (CANH)
/Peripheral/CAN_L: J6.2, R24.2, U6.6 (CANL)
/Peripheral/OTG_D+: J7.3 (D+), R38.2
/Peripheral/OTG_D-: J7.2 (D-), R39.1
ADC1_IN2: RV2.2; also elsewhere on the board
ADC1_IN3: RV3.2; also elsewhere on the board
ADC1_IN4: RV4.2; also elsewhere on the board
ADC2_IN14: R27.2, R28.1; also elsewhere on the board
CAN_Rx: U6.4 (R); also elsewhere on the board
CAN_Tx: U6.1 (D); also elsewhere on the board
DREQ: J8.7; also elsewhere on the board
GND: BT1.2 (-), C37.2, C38.2, C39.2, C40.2, C41.2, C42.2, C43.2, C44.2, C45.2, C46.2, C47.1, C48.1, C49.2, C50.2, C51.1, C52.2, C53.2, C54.1, D4.1 (K), D5.1 (K), DS1.1 (VSS), DS1.5 (R/W), DS1.16 (LED(-)), EEPROM1.1 (A0), EEPROM1.2 (A1), EEPROM1.3 (A2), EEPROM1.4 (GND), FB9.2, FB11.1, J5.3, J7.4 (GND), J8.3, J8.4, Q1.2 (S), R19.1, R22.2, R28.2, RV1.1, RV2.3, RV3.3, RV4.3, SD1.3 (VSS), SD1.6 (VSS), SW3.3, SW4.3, SW5.3, SW6.3, Temp1.A1 (VSS), Temp1.B2 (ADD0), Temp2.A1 (VSS), U6.2 (GND), U7.2 (GND), U8.5 (GND), U8.6 (GND), U8.7 (GND), U8.8 (GND), U8.9 (GND), U8.10 (GND), U8.11 (GND), U8.12 (GND), U8.13 (GND); also elsewhere on the board
I2C1_SCL: EEPROM1.6 (SCL), R37.2, Temp1.C1 (SCL), Temp2.C1 (SCL), U8.16 (SCL); also elsewhere on the board
I2C1_SDA: EEPROM1.5 (SDA), R40.2, Temp1.C2 (SDA), Temp2.C2 (SDA), U8.15 (SDA); also elsewhere on the board
unnamed: BT1.1 (+), TP4.1, U8.14 (VBAT)
unnamed: BZ1.2 (-), Q1.3 (D)
unnamed: D4.2 (A), R17.2
unnamed: D5.2 (A), R18.2
unnamed: D6.2 (A), R32.2
unnamed: D7.1 (K), J7.1 (VBUS)
unnamed: DS1.15 (LED(+)), R25.1
unnamed: FB11.2, J7.5 (Shield)
unnamed: Q1.1 (G), R21.2, R22.1
unnamed: C49.1, FB7.2, Temp1.A2 (VDD)
unnamed: C50.1, FB8.2, Temp2.A2 (VDD)
unnamed: R19.2, U6.8 (Rs)
unnamed: C51.2, FB10.1, U7.1 (OUT)
OTG_FS_OC: D6.1 (K), R31.2, U7.3 (~FAULT); also elsewhere on the board
OTG_FS_PSO: R30.2, U7.4 (~EN); also elsewhere on the board
PB3: J5.1, TP3.1; also elsewhere on the board
PB4: R17.1; also elsewhere on the board
PB5: R18.1; also elsewhere on the board
PB12: EEPROM1.7 (WP), R29.2; also elsewhere on the board
PC0: C37.1, R16.2, SW3.1; also elsewhere on the board
PC1: C40.1, R20.2, SW4.1; also elsewhere on the board
PC2: C42.1, R23.2, SW5.1; also elsewhere on the board
PC3: C43.1, R26.2, SW6.1; also elsewhere on the board
PD4: R33.2, Temp1.B1 (Alert/ADD1); also elsewhere on the board
PD5: R34.2, Temp2.B1 (Alert/ADD1); also elsewhere on the board
PD10: DS1.14 (D7); also elsewhere on the board
PD11: DS1.13 (D6); also elsewhere on the board
PD12: DS1.12 (D5); also elsewhere on the board
PD13: DS1.11 (D4); also elsewhere on the board
PD14: DS1.6 (E); also elsewhere on the board
PD15: DS1.4 (RS); also elsewhere on the board
PE9: R21.1, TP2.1; also elsewhere on the board
PE10: J8.12; also elsewhere on the board
SDIO_CLK: R45.1, SD1.5 (CLK); also elsewhere on the board
SDIO_CMD: R46.1, SD1.2 (CMD); also elsewhere on the board
SDIO_D0: R41.1, SD1.7 (DAT0); also elsewhere on the board
SDIO_D1: R42.1, SD1.8 (DAT1); also elsewhere on the board
SDIO_D2: R43.1, SD1.9 (DAT2); also elsewhere on the board
SDIO_D3: R44.1, SD1.1 (CD/DAT3); also elsewhere on the board
SDIO_INT: R35.1, SD1.CD_IND (CD_INT); also elsewhere on the board
SDIO_WP: R36.1, SD1.WP; also elsewhere on the board
SHIELD_GND: FB9.1, SD1.G1 (SHIELD_GND), SD1.G2 (SHIELD_GND), SD1.G3 (SHIELD_GND), SD1.G4 (SHIELD_GND)
SPI1_MISO: J8.6; also elsewhere on the board
SPI1_MOSI: J8.8; also elsewhere on the board
SPI1_SCK: J8.10; also elsewhere on the board
USB_OTG_D+: R38.1; also elsewhere on the board
USB_OTG_D-: R39.2; also elsewhere on the board
VBUS_FS: C52.1, D7.2 (A), FB10.2; also elsewhere on the board
VO: DS1.3 (VO), RV1.2
xDCS: J8.11; also elsewhere on the board
xRESET: J8.9; also elsewhere on the board

Notes on the sheet:
Address: 0x48
CLCD
Analog
Buttons
Buzzer
Servo
VS1003
Address: 0x68
RTC
EEPROM
LED
CAN
Address: 0xA0
SPI
I2C
Temp Sensors
USB
SD Card
PWM
GPIO
SDIO
Address: 0x49

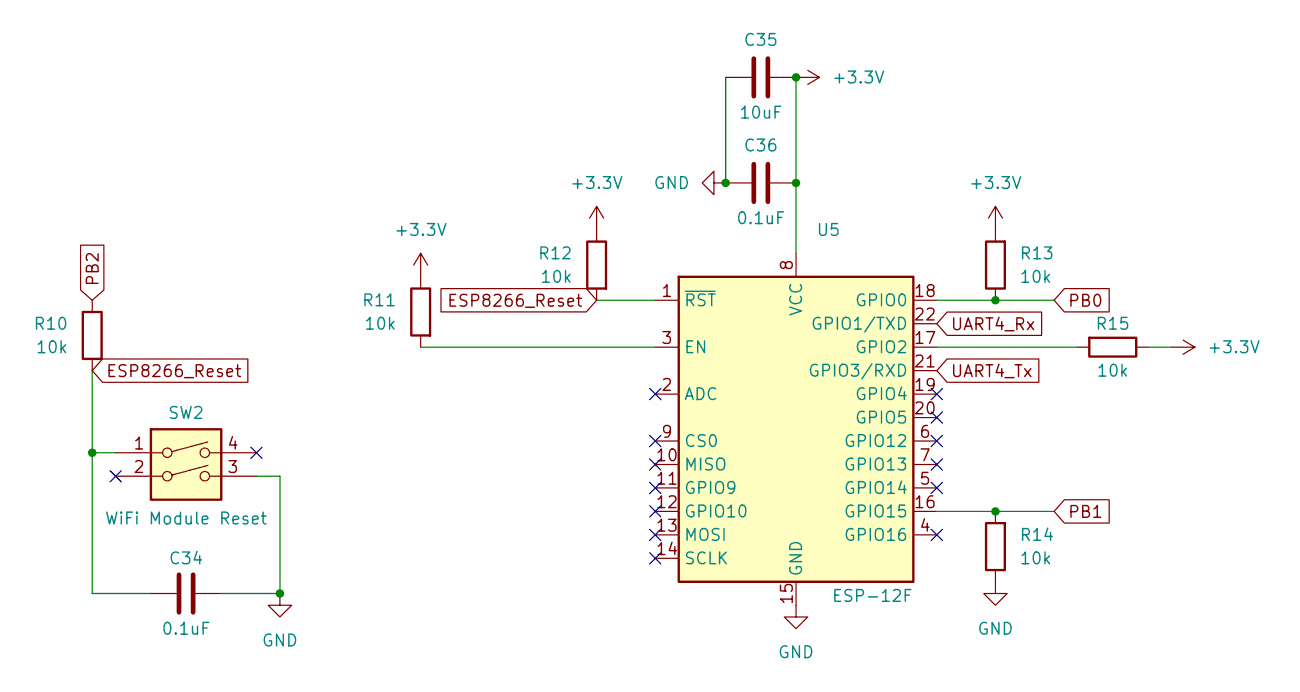
[picture p261: schematic WiFi Module.kicad_sch, IOT]

Parts:
C34, C36: 0.1uF; C_0805_2012Metric
C35: 10uF; C_1206_3216Metric
R10, R11, R12, R13, R14, R15: 10k; R_0805_2012Metric
SW2: WiFi Module Reset; SW_SMD_IT-1107
U5: ESP-12F; ESP-12E

Connections:
+3.3V: C35.2, C36.2, R11.1, R12.1, R13.2, R15.1, U5.8 (VCC); also elsewhere on the board
ESP8266_Reset: C34.1, R10.2, R12.2, SW2.1, U5.1 (~RST)
GND: C34.2, C35.1, C36.1, R14.1, SW2.3, U5.15 (GND); also elsewhere on the board
unnamed: R11.2, U5.3 (EN)
unnamed: R15.2, U5.17 (GPIO2)
PB0: R13.1, U5.18 (GPIO0); also elsewhere on the board
PB1: R14.2, U5.16 (GPIO15); also elsewhere on the board
PB2: R10.1; also elsewhere on the board
UART4_Rx: U5.22 (GPIO1/TXD); also elsewhere on the board
UART4_Tx: U5.21 (GPIO3/RXD); also elsewhere on the board

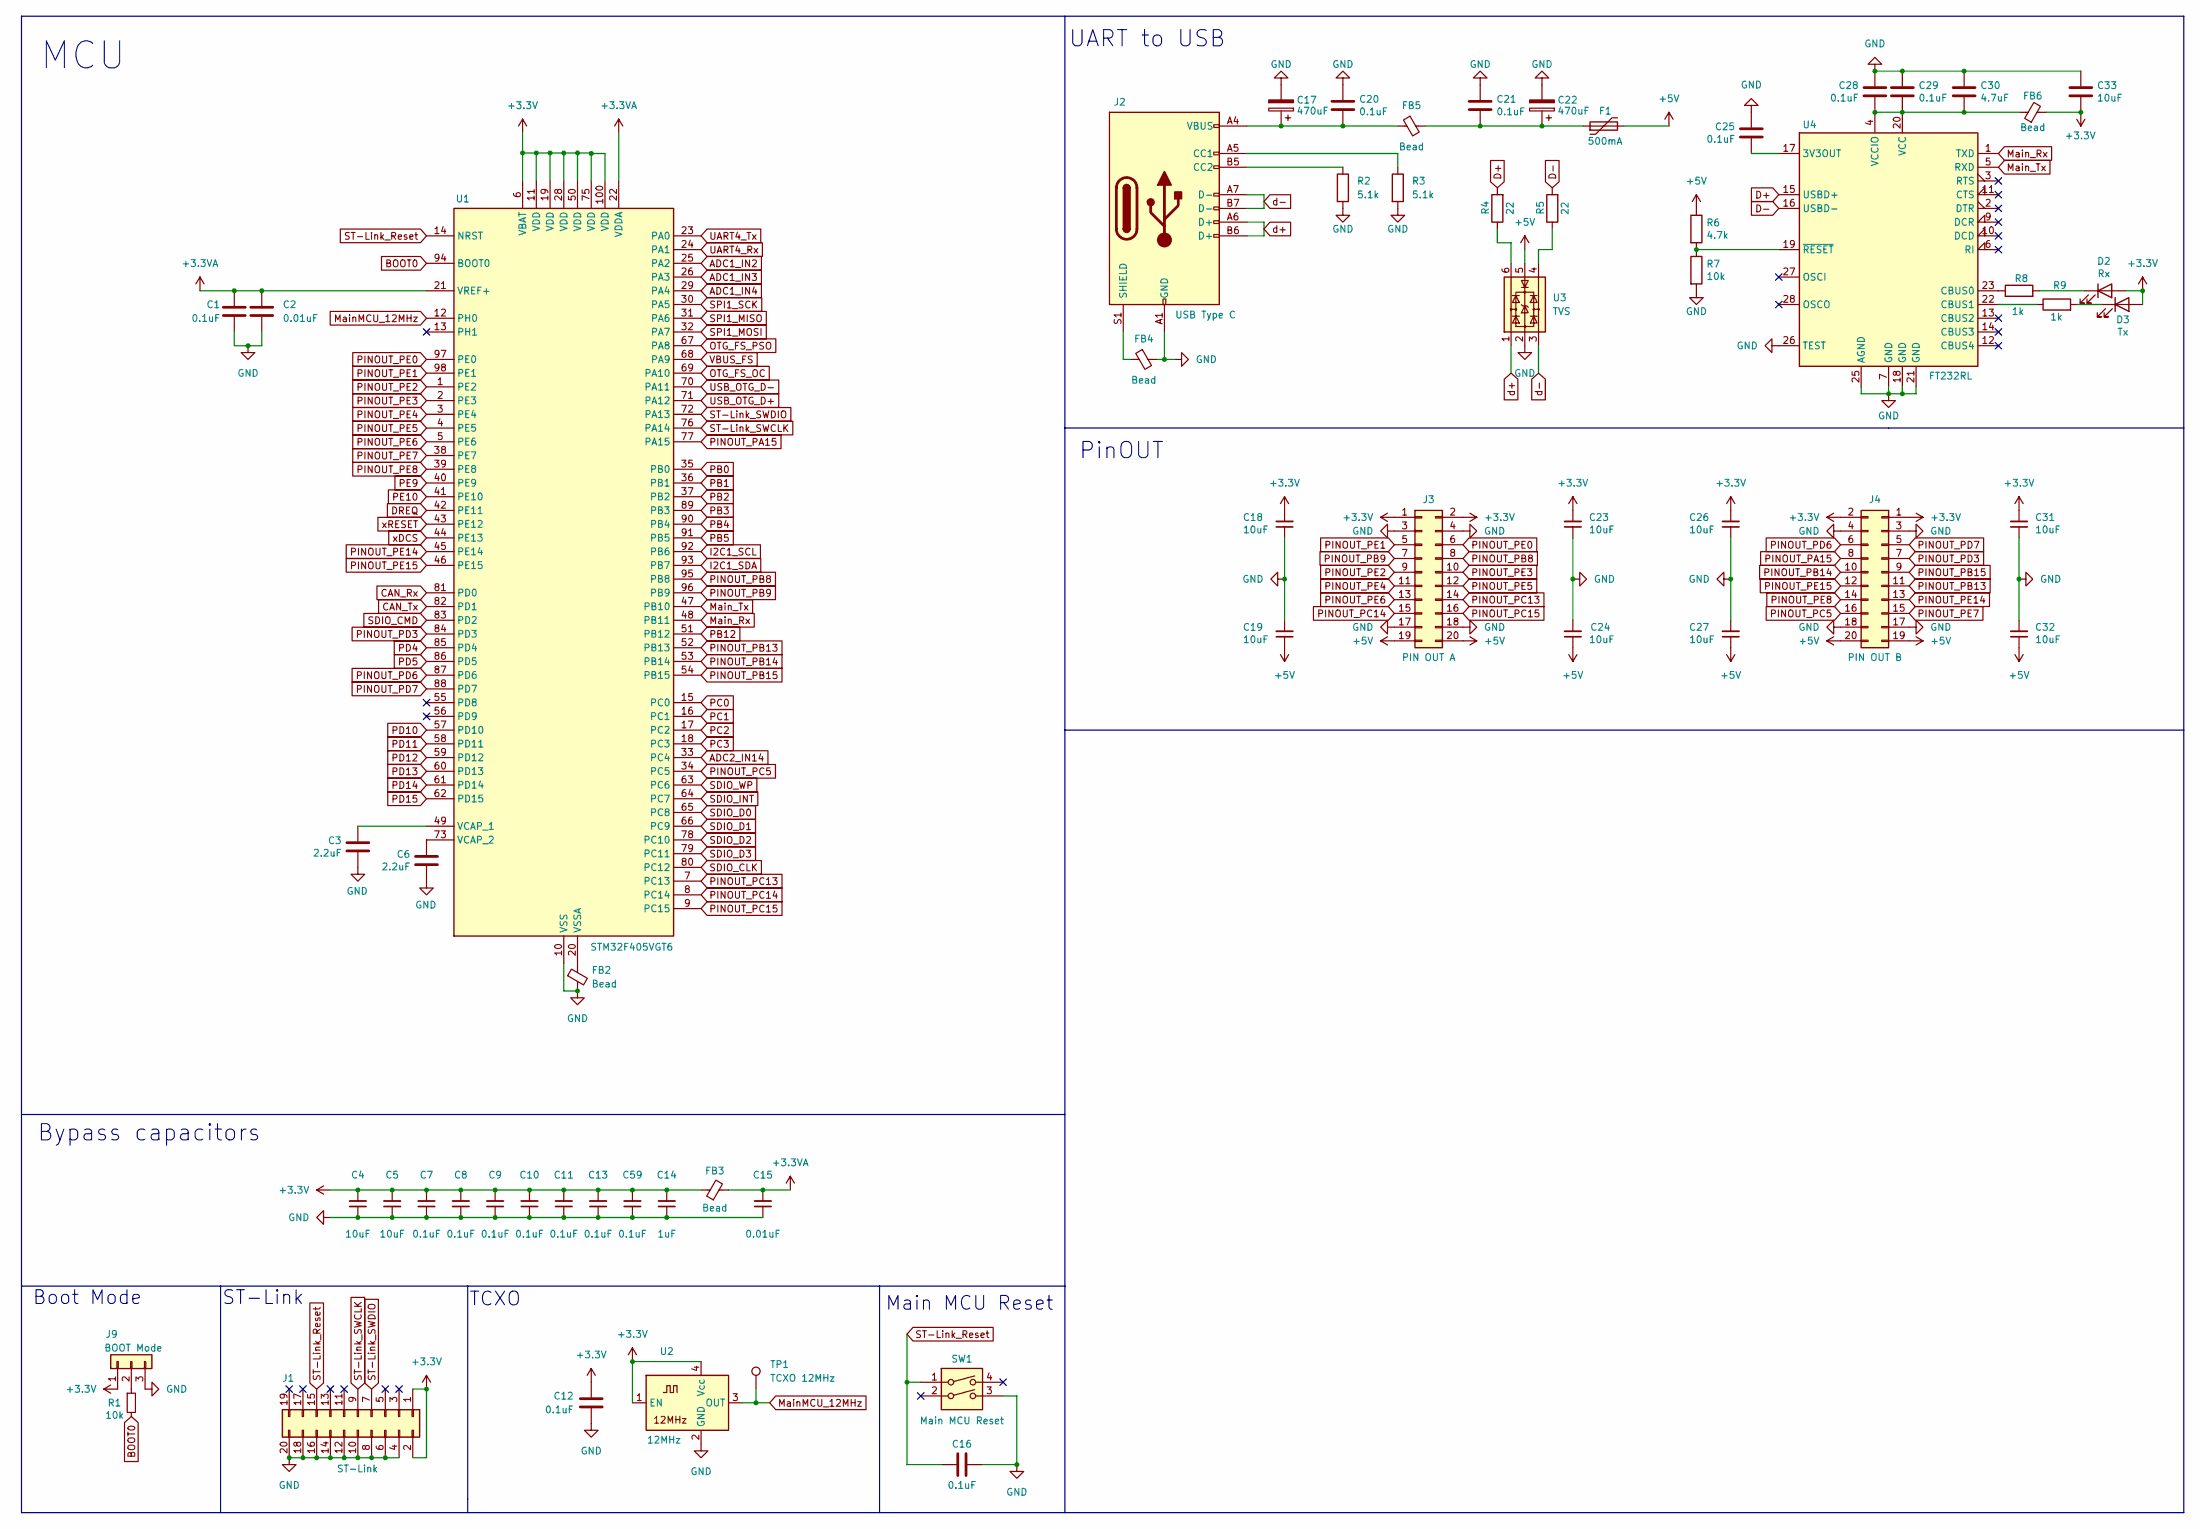
[picture p262: schematic MCU.kicad_sch]

Parts:
C1, C7, C8, C9, C10, C11, C12, C13, C16, C20, C21, C25, C28, C29, C59: 0.1uF; C_0805_2012Metric
C2, C15: 0.01uF; C_0805_2012Metric
C3, C6: 2.2uF; C_0805_2012Metric
C4, C5, C18, C19, C23, C24, C26, C27, C31, C32, C33: 10uF; C_1206_3216Metric
C14: 1uF; C_0805_2012Metric
C17, C22: 470uF; MVG25WV470M
C30: 4.7uF; C_0805_2012Metric
D2: Rx; LED_0805_2012Metric
D3: Tx; LED_0805_2012Metric
F1: 500mA; L_1210_3225Metric
FB2, FB3, FB4, FB5, FB6: Bead; L_0805_2012Metric
J1: ST-Link; IDC-Header_2x10_P2.54mm_Vertical
J2: USB Type C; USB_C_Receptacle_HRO_TYPE-C-31-M-12
J3: PIN OUT A; PinHeader_2x10_P2.54mm_Vertical
J4: PIN OUT B; PinHeader_2x10_P2.54mm_Vertical
J9: BOOT Mode; PinHeader_1x03_P2.54mm_Vertical
R1, R7: 10k; R_0805_2012Metric
R2, R3: 5.1k; R_0805_2012Metric
R4, R5: 22; R_0805_2012Metric
R6: 4.7k; R_0805_2012Metric
R8, R9: 1k; R_0805_2012Metric
SW1: Main MCU Reset; SW_SMD_IT-1107
TP1: TCXO 12MHz; TestPoint_Pad_D1.5mm
U1: STM32F405VGT6; LQFP-100_14x14mm_P0.5mm
U2: 12MHz; ECS-TXO-2016
U3: TVS; SOT-23-6
U4: FT232RL; SSOP-28_5.3x10.2mm_P0.65mm

Connections:
+3.3V: C4.2, C5.2, C7.2, C8.2, C9.2, C10.2, C11.2, C12.1, C13.2, C14.2, C18.2, C23.2, C26.2, C31.2, C33.1, C59.2, D2.2 (A), D3.2 (A), FB3.1, FB6.2, J1.1, J1.2, J3.1, J3.2, J4.1, J4.2, J9.1, U1.6 (VBAT), U1.11 (VDD), U1.19 (VDD), U1.28 (VDD), U1.50 (VDD), U1.75 (VDD), U1.100 (VDD), U2.1 (EN), U2.4 (Vcc); also elsewhere on the board
+3.3VA: C1.2, C2.2, C15.2, FB3.2, U1.21 (VREF+), U1.22 (VDDA)
+5V: C19.1, C24.1, C27.1, C32.1, F1.2, J3.19, J3.20, J4.19, J4.20, R6.1, U3.5; also elsewhere on the board
ADC1_IN2: U1.25 (PA2); also elsewhere on the board
ADC1_IN3: U1.26 (PA3); also elsewhere on the board
ADC1_IN4: U1.29 (PA4); also elsewhere on the board
ADC2_IN14: U1.33 (PC4); also elsewhere on the board
BOOT0: R1.2, U1.94 (BOOT0)
CAN_Rx: U1.81 (PD0); also elsewhere on the board
CAN_Tx: U1.82 (PD1); also elsewhere on the board
D+: R4.2, U4.15 (USBD+)
D-: R5.2, U4.16 (USBD-)
DREQ: U1.42 (PE11); also elsewhere on the board
GND: C1.1, C2.1, C3.2, C4.1, C5.1, C6.2, C7.1, C8.1, C9.1, C10.1, C11.1, C12.2, C13.1, C14.1, C15.1, C16.2, C17.2, C18.1, C19.2, C20.2, C21.2, C22.2, C23.1, C24.2, C25.2, C26.1, C27.2, C28.2, C29.2, C30.2, C31.1, C32.2, C33.2, C59.1, FB2.2, FB4.2, J1.4, J1.6, J1.8, J1.10, J1.12, J1.14, J1.16, J1.18, J1.20, J2.A1 (GND), J2.A12 (GND), J2.B1 (GND), J2.B12 (GND), J3.3, J3.4, J3.17, J3.18, J4.3, J4.4, J4.17, J4.18, J9.3, R2.2, R3.2, R7.2, SW1.3, U1.10 (VSS), U1.27 (VSS), U1.74 (VSS), U1.99 (VSS), U2.2 (GND), U3.2, U4.7 (GND), U4.18 (GND), U4.21 (GND), U4.25 (AGND), U4.26 (TEST); also elsewhere on the board
I2C1_SCL: U1.92 (PB6); also elsewhere on the board
I2C1_SDA: U1.93 (PB7); also elsewhere on the board
MainMCU_12MHz: TP1.1, U1.12 (PH0), U2.3 (OUT)
Main_Rx: U1.48 (PB11), U4.1 (TXD)
Main_Tx: U1.47 (PB10), U4.5 (RXD)
unnamed: C17.1, C20.1, FB5.1, J2.A4 (VBUS), J2.A9 (VBUS), J2.B4 (VBUS), J2.B9 (VBUS)
unnamed: C21.1, C22.1, F1.1, FB5.2
unnamed: D2.1 (K), R8.2
unnamed: D3.1 (K), R9.2
unnamed: J2.A5 (CC1), R3.1
unnamed: J2.B5 (CC2), R2.1
unnamed: FB4.1, J2.S1 (SHIELD)
unnamed: J9.2, R1.1
unnamed: R4.1, U3.6
unnamed: R5.1, U3.4
unnamed: C3.1, U1.49 (VCAP_1)
unnamed: C6.1, U1.73 (VCAP_2)
unnamed: FB2.1, U1.20 (VSSA)
unnamed: C25.1, U4.17 (3V3OUT)
unnamed: R8.1, U4.23 (CBUS0)
unnamed: R9.1, U4.22 (CBUS1)
unnamed: C28.1, C29.1, C30.1, FB6.1, U4.4 (VCCIO), U4.20 (VCC)
unnamed: R6.2, R7.1, U4.19 (~RESET)
OTG_FS_OC: U1.69 (PA10); also elsewhere on the board
OTG_FS_PSO: U1.67 (PA8); also elsewhere on the board
PB0: U1.35 (PB0); also elsewhere on the board
PB1: U1.36 (PB1); also elsewhere on the board
PB2: U1.37 (PB2); also elsewhere on the board
PB3: U1.89 (PB3); also elsewhere on the board
PB4: U1.90 (PB4); also elsewhere on the board
PB5: U1.91 (PB5); also elsewhere on the board
PB12: U1.51 (PB12); also elsewhere on the board
PC0: U1.15 (PC0); also elsewhere on the board
PC1: U1.16 (PC1); also elsewhere on the board
PC2: U1.17 (PC2); also elsewhere on the board
PC3: U1.18 (PC3); also elsewhere on the board
PD4: U1.85 (PD4); also elsewhere on the board
PD5: U1.86 (PD5); also elsewhere on the board
PD10: U1.57 (PD10); also elsewhere on the board
PD11: U1.58 (PD11); also elsewhere on the board
PD12: U1.59 (PD12); also elsewhere on the board
PD13: U1.60 (PD13); also elsewhere on the board
PD14: U1.61 (PD14); also elsewhere on the board
PD15: U1.62 (PD15); also elsewhere on the board
PE9: U1.40 (PE9); also elsewhere on the board
PE10: U1.41 (PE10); also elsewhere on the board
PINOUT_PA15: J4.8, U1.77 (PA15)
PINOUT_PB8: J3.8, U1.95 (PB8)
PINOUT_PB9: J3.7, U1.96 (PB9)
PINOUT_PB13: J4.11, U1.52 (PB13)
PINOUT_PB14: J4.10, U1.53 (PB14)
PINOUT_PB15: J4.9, U1.54 (PB15)
PINOUT_PC5: J4.16, U1.34 (PC5)
PINOUT_PC13: J3.14, U1.7 (PC13)
PINOUT_PC14: J3.15, U1.8 (PC14)
PINOUT_PC15: J3.16, U1.9 (PC15)
PINOUT_PD3: J4.7, U1.84 (PD3)
PINOUT_PD6: J4.6, U1.87 (PD6)
PINOUT_PD7: J4.5, U1.88 (PD7)
PINOUT_PE0: J3.6, U1.97 (PE0)
PINOUT_PE1: J3.5, U1.98 (PE1)
PINOUT_PE2: J3.9, U1.1 (PE2)
PINOUT_PE3: J3.10, U1.2 (PE3)
PINOUT_PE4: J3.11, U1.3 (PE4)
PINOUT_PE5: J3.12, U1.4 (PE5)
PINOUT_PE6: J3.13, U1.5 (PE6)
PINOUT_PE7: J4.15, U1.38 (PE7)
PINOUT_PE8: J4.14, U1.39 (PE8)
PINOUT_PE14: J4.13, U1.45 (PE14)
PINOUT_PE15: J4.12, U1.46 (PE15)
SDIO_CLK: U1.80 (PC12); also elsewhere on the board
SDIO_CMD: U1.83 (PD2); also elsewhere on the board
SDIO_D0: U1.65 (PC8); also elsewhere on the board
SDIO_D1: U1.66 (PC9); also elsewhere on the board
SDIO_D2: U1.78 (PC10); also elsewhere on the board
SDIO_D3: U1.79 (PC11); also elsewhere on the board
SDIO_INT: U1.64 (PC7); also elsewhere on the board
SDIO_WP: U1.63 (PC6); also elsewhere on the board
SPI1_MISO: U1.31 (PA6); also elsewhere on the board
SPI1_MOSI: U1.32 (PA7); also elsewhere on the board
SPI1_SCK: U1.30 (PA5); also elsewhere on the board
ST-Link_Reset: C16.1, J1.15, SW1.1, U1.14 (NRST)
ST-Link_SWCLK: J1.9, U1.76 (PA14)
ST-Link_SWDIO: J1.7, U1.72 (PA13)
UART4_Rx: U1.24 (PA1); also elsewhere on the board
UART4_Tx: U1.23 (PA0); also elsewhere on the board
USB_OTG_D+: U1.71 (PA12); also elsewhere on the board
USB_OTG_D-: U1.70 (PA11); also elsewhere on the board
VBUS_FS: U1.68 (PA9); also elsewhere on the board
d+: J2.A6 (D+), J2.B6 (D+), U3.1
d-: J2.A7 (D-), J2.B7 (D-), U3.3
xDCS: U1.44 (PE13); also elsewhere on the board
xRESET: U1.43 (PE12); also elsewhere on the board

Notes on the sheet:
UART to USB
Bypass capacitors
TCXO
MCU
Main MCU Reset
Boot Mode
ST-Link
PinOUT

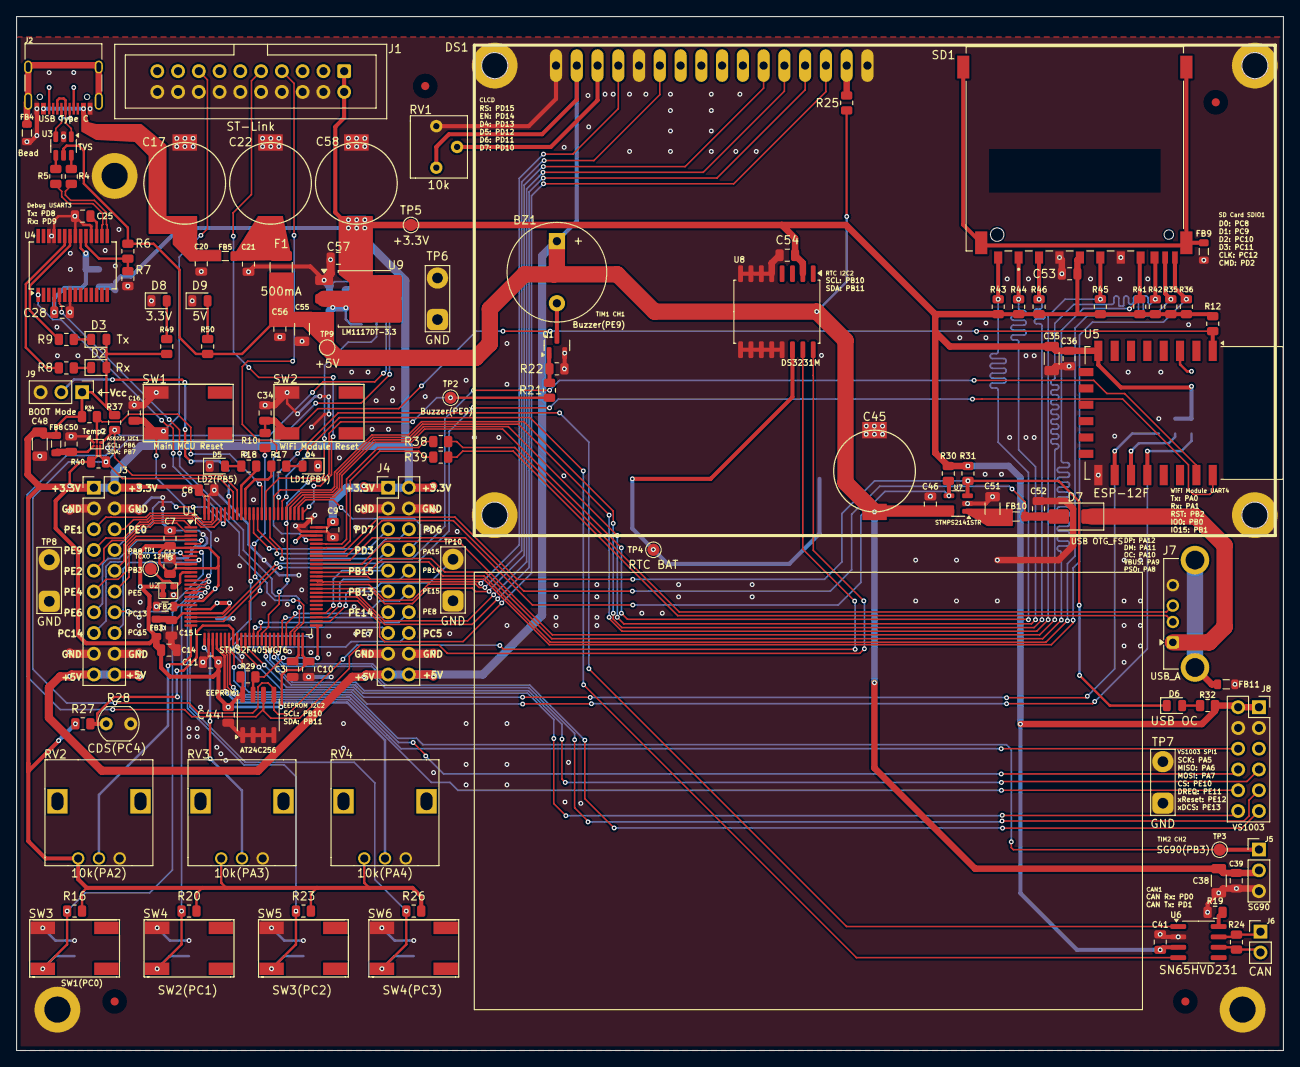
[picture p263: board ARM 세미나 보드.kicad_pcb from above]

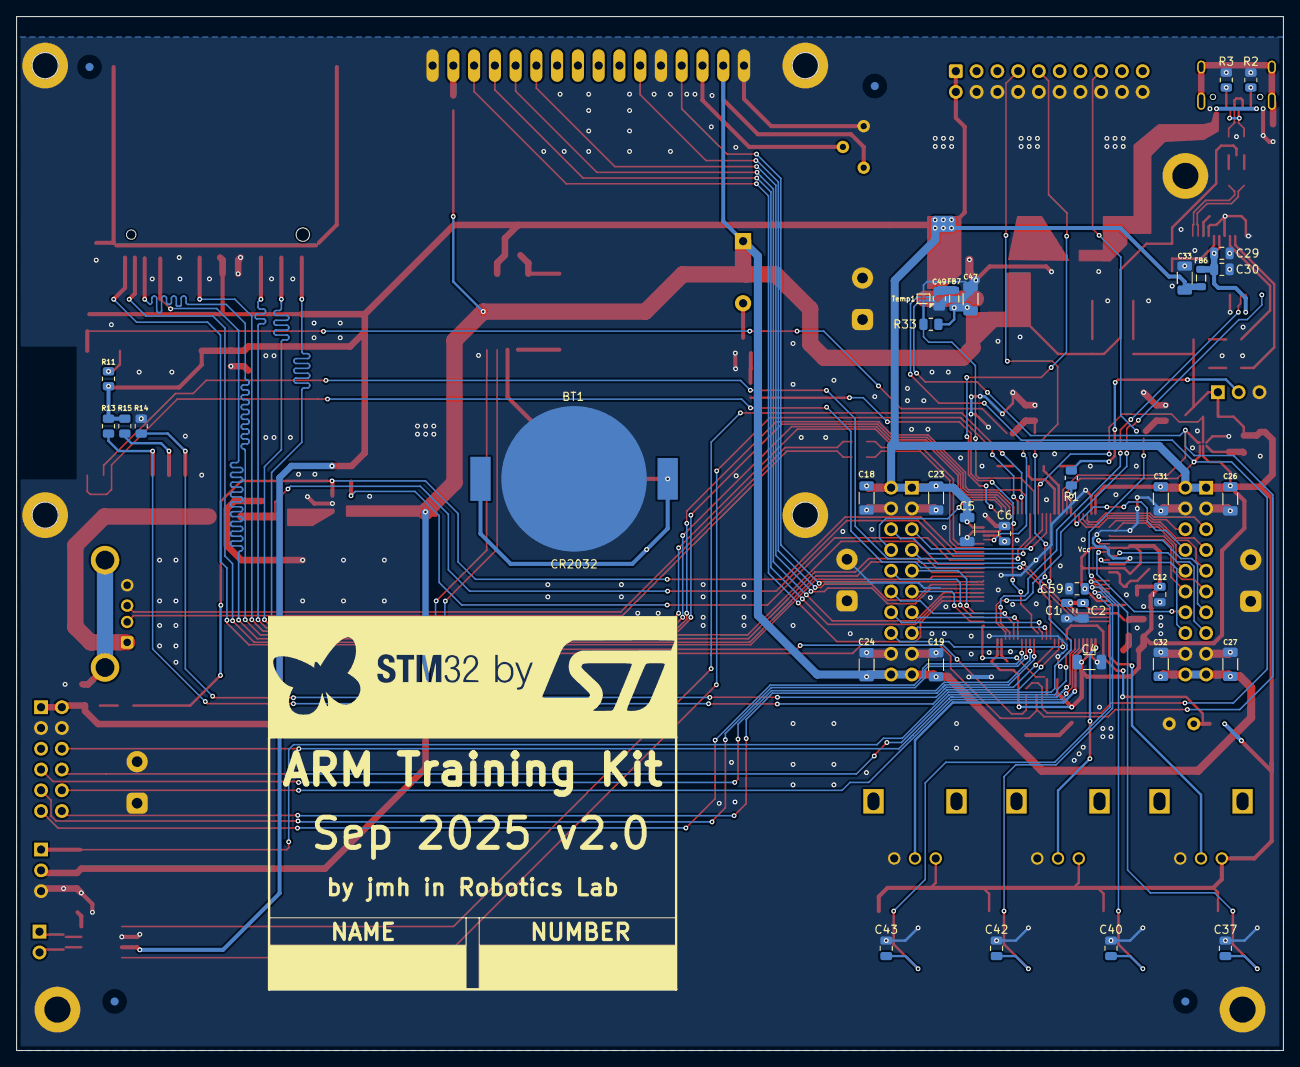
[picture p264: board ARM 세미나 보드.kicad_pcb from below]

Board: 2 copper layers, 155.0 x 126.5 mm, 172 parts (36 on the bottom side), 131 nets.
