jmh8231-Dev/arm-seminar/Code/ESP12F_FW_Updater/Core/Src/main.c

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
/* Includes ------------------------------------------------------------------*/
#include "main.h"
#include "dma.h"
#include "usart.h"
#include "gpio.h"

/* USER CODE BEGIN Includes */
#include <stdint.h>
#include <string.h>


/* USER CODE END Includes */


/* USER CODE BEGIN PV */
#define RX_SZ   (512u)
#define TX_SZ   (512u)   /* RX_SZ 이상 권장 */

static uint8_t pc_rx_buf[2][RX_SZ];     /* USART3 RX ping-pong */
static uint8_t esp_rx_buf[2][RX_SZ];    /* UART4  RX ping-pong */
static volatile uint8_t pc_rx_sel  = 0u;
static volatile uint8_t esp_rx_sel = 0u;

/* PC->ESP (UART4 TX) : tx buffer 2개 + pending 1개 */
static uint8_t pc2esp_tx_buf[2][TX_SZ];
static volatile uint8_t  pc2esp_busy = 0u;
static volatile uint8_t  pc2esp_active_id = 0u;
static volatile uint8_t  pc2esp_pending = 0u;
static volatile uint8_t  pc2esp_pending_id = 0u;
static volatile uint16_t pc2esp_pending_len = 0u;

/* ESP->PC (USART3 TX) : tx buffer 2개 + pending 1개 */
static uint8_t esp2pc_tx_buf[2][TX_SZ];
static volatile uint8_t  esp2pc_busy = 0u;
static volatile uint8_t  esp2pc_active_id = 0u;
static volatile uint8_t  esp2pc_pending = 0u;
static volatile uint8_t  esp2pc_pending_id = 0u;
static volatile uint16_t esp2pc_pending_len = 0u;

/* USER CODE END PV */

void SystemClock_Config(void);
static void MX_NVIC_Init(void);
/* USER CODE BEGIN PFP */
static void Bridge_Start(void);
static void ESP_EnterBootloader(void);


/* USER CODE END PFP */

/* USER CODE BEGIN 0 */
static void start_rx_usart3(void)
{
    (void)HAL_UARTEx_ReceiveToIdle_DMA(&huart3, pc_rx_buf[pc_rx_sel], RX_SZ);
    if (huart3.hdmarx) __HAL_DMA_DISABLE_IT(huart3.hdmarx, DMA_IT_HT);
}

static void start_rx_uart4(void)
{
    (void)HAL_UARTEx_ReceiveToIdle_DMA(&huart4, esp_rx_buf[esp_rx_sel], RX_SZ);
    if (huart4.hdmarx) __HAL_DMA_DISABLE_IT(huart4.hdmarx, DMA_IT_HT);
}

/* ESP8266 Download Mode: GPIO0=LOW, RST 펄스 */
static void ESP_EnterBootloader(void)
{

	if(HAL_GPIO_ReadPin(GPIOC, GPIO_PIN_0) == GPIO_PIN_RESET) {
		/* GPIO0(BOOT)=LOW */
		HAL_GPIO_WritePin(ESP12F_Boot_GPIO_Port, ESP12F_Boot_Pin, GPIO_PIN_SET);
		HAL_GPIO_WritePin(LD0_GPIO_Port, LD0_Pin, GPIO_PIN_SET);
	}
	else {
		HAL_GPIO_WritePin(ESP12F_Boot_GPIO_Port, ESP12F_Boot_Pin, GPIO_PIN_RESET);
		HAL_GPIO_WritePin(LD0_GPIO_Port, LD0_Pin, GPIO_PIN_RESET);
	}

    /* RST: LOW->HIGH */
    HAL_GPIO_WritePin(ESP12F_RST_GPIO_Port, ESP12F_RST_Pin, GPIO_PIN_RESET);
    HAL_Delay(500);
    HAL_GPIO_WritePin(ESP12F_RST_GPIO_Port, ESP12F_RST_Pin, GPIO_PIN_SET);
    HAL_Delay(100);
}

static void Bridge_Start(void)
{
    pc_rx_sel  = 0u;
    esp_rx_sel = 0u;

    pc2esp_busy = 0u; pc2esp_pending = 0u;
    esp2pc_busy = 0u; esp2pc_pending = 0u;

    start_rx_usart3();
    start_rx_uart4();
}

/* RX 이벤트(Idle 또는 버퍼 full) */
void HAL_UARTEx_RxEventCallback(UART_HandleTypeDef *huart, uint16_t Size)
{
    if (Size == 0u) return;

    if (huart->Instance == USART3) {
        /* --- PC(USART3) -> ESP(UART4) --- */
        uint8_t used_rx = pc_rx_sel;
        pc_rx_sel ^= 1u;
        start_rx_usart3(); /* 먼저 다음 RX 걸기 (다른 버퍼로) */

        if (Size > TX_SZ) Size = TX_SZ;

        if (!pc2esp_busy) {
            /* TX idle: active로 시작 */
            uint8_t txid = 0u;
            (void)memcpy(pc2esp_tx_buf[txid], pc_rx_buf[used_rx], Size);
            pc2esp_busy = 1u;
            pc2esp_active_id = txid;
            (void)HAL_UART_Transmit_DMA(&huart4, pc2esp_tx_buf[txid], Size);
        } else if (!pc2esp_pending) {
            /* TX busy: 반대 버퍼에 1개만 대기 */
            uint8_t txid = (uint8_t)(pc2esp_active_id ^ 1u);
            (void)memcpy(pc2esp_tx_buf[txid], pc_rx_buf[used_rx], Size);
            pc2esp_pending = 1u;
            pc2esp_pending_id = txid;
            pc2esp_pending_len = Size;
        } else {
            /* pending까지 차면 드롭(여기 오면 TX_SZ/RX_SZ 키우거나 baud 낮추면 됨) */
        }
    }
    else if (huart->Instance == UART4) {
        /* --- ESP(UART4) -> PC(USART3) --- */
        uint8_t used_rx = esp_rx_sel;
        esp_rx_sel ^= 1u;
        start_rx_uart4(); /* 다음 RX */

        if (Size > TX_SZ) Size = TX_SZ;

        if (!esp2pc_busy) {
            uint8_t txid = 0u;
            (void)memcpy(esp2pc_tx_buf[txid], esp_rx_buf[used_rx], Size);
            esp2pc_busy = 1u;
            esp2pc_active_id = txid;
            (void)HAL_UART_Transmit_DMA(&huart3, esp2pc_tx_buf[txid], Size);
        } else if (!esp2pc_pending) {
            uint8_t txid = (uint8_t)(esp2pc_active_id ^ 1u);
            (void)memcpy(esp2pc_tx_buf[txid], esp_rx_buf[used_rx], Size);
            esp2pc_pending = 1u;
            esp2pc_pending_id = txid;
            esp2pc_pending_len = Size;
        } else {
            /* drop */
        }
    }
}

/* TX 완료 콜백: pending 있으면 이어서 전송 */
void HAL_UART_TxCpltCallback(UART_HandleTypeDef *huart)
{
    if (huart->Instance == UART4) {
        /* PC->ESP */
        if (pc2esp_pending) {
            pc2esp_pending = 0u;
            pc2esp_active_id = pc2esp_pending_id;
            (void)HAL_UART_Transmit_DMA(&huart4,
                                       pc2esp_tx_buf[pc2esp_active_id],
                                       pc2esp_pending_len);
        } else {
            pc2esp_busy = 0u;
        }
    }
    else if (huart->Instance == USART3) {
        /* ESP->PC */
        if (esp2pc_pending) {
            esp2pc_pending = 0u;
            esp2pc_active_id = esp2pc_pending_id;
            (void)HAL_UART_Transmit_DMA(&huart3,
                                       esp2pc_tx_buf[esp2pc_active_id],
                                       esp2pc_pending_len);
        } else {
            esp2pc_busy = 0u;
        }
    }
}

/* UART 에러 시 RX 재시작 */
void HAL_UART_ErrorCallback(UART_HandleTypeDef *huart)
{
    if (huart->Instance == USART3) {
        start_rx_usart3();
    } else if (huart->Instance == UART4) {
        start_rx_uart4();
    }
}


/* USER CODE END 0 */

/**
  * @brief  The application entry point.
  * @retval int
  */
int main(void)
{

  /* MCU Configuration--------------------------------------------------------*/

  /* Reset of all peripherals, Initializes the Flash interface and the Systick. */
  HAL_Init();

  /* Configure the system clock */
  SystemClock_Config();

  /* Initialize all configured peripherals */
  MX_GPIO_Init();
  MX_DMA_Init();
  MX_USART3_UART_Init();
  MX_UART4_Init();

  /* Initialize interrupts */
  MX_NVIC_Init();
  /* USER CODE BEGIN 2 */
  ESP_EnterBootloader();  /* ESP를 항상 Download Mode로 넣고 시작 */
  Bridge_Start();

  /* USER CODE END 2 */

  /* Infinite loop */
  /* USER CODE BEGIN WHILE */
  while (1)
  {
    /* USER CODE END WHILE */

    /* USER CODE BEGIN 3 */
  }
  /* USER CODE END 3 */
}

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
