jmh8231-Dev/arm-seminar/Code/ESP12F_FW_Updater/Core/Inc/main.h

#define ESP12F_Rx_Pin GPIO_PIN_0
#define ESP12F_Rx_GPIO_Port GPIOA
#define ESP12F_Tx_Pin GPIO_PIN_1
#define ESP12F_Tx_GPIO_Port GPIOA
#define ESP12F_Boot_Pin GPIO_PIN_0
#define ESP12F_Boot_GPIO_Port GPIOB
#define ESP12F_RST_Pin GPIO_PIN_2
#define ESP12F_RST_GPIO_Port GPIOB
#define D7_Pin GPIO_PIN_10
#define D7_GPIO_Port GPIOD
#define D6_Pin GPIO_PIN_11
#define D6_GPIO_Port GPIOD
#define D5_Pin GPIO_PIN_12
#define D5_GPIO_Port GPIOD
#define D4_Pin GPIO_PIN_13
#define D4_GPIO_Port GPIOD
#define EN_Pin GPIO_PIN_14
#define EN_GPIO_Port GPIOD
#define RS_Pin GPIO_PIN_15
#define RS_GPIO_Port GPIOD
#define LD1_Pin GPIO_PIN_4
#define LD1_GPIO_Port GPIOB
#define LD0_Pin GPIO_PIN_5
#define LD0_GPIO_Port GPIOB
