jmh8231-Dev/arm-seminar/(commit log)

2025-09-17 add HW v2.0
    [ARM 세미나 보드 Bom.csv, ARM 세미나 보드.kicad_pcb, ARM 세미나 보드.kicad_sch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]
2025-09-25 Create ARM Training Kit v2.0 sch.pdf
2025-11-13 Create STM32F405 Errata.pdf
2026-01-04 Update ARM 세미나 10주차.pptx
2026-01-23 Create Artwork 세미나 3회차.pptx
2026-01-23 Update Artwork 세미나 3회차.pptx
