jmh8231-Dev/arm-seminar/(notices)

Notices in the files:
Code/ESP12F_FW_Updater/Core/Inc/main.h:
Copyright (c) 2025 STMicroelectronics.
All rights reserved.
This software is licensed under terms that can be found in the LICENSE file
Code/ESP12F_FW_Updater/Core/Src/main.c:
Copyright (c) 2026 STMicroelectronics.
